neuroMoth/3-Port-4-Bottle-Rig/Documentation and Reference Material/wiring_diagram.jpg

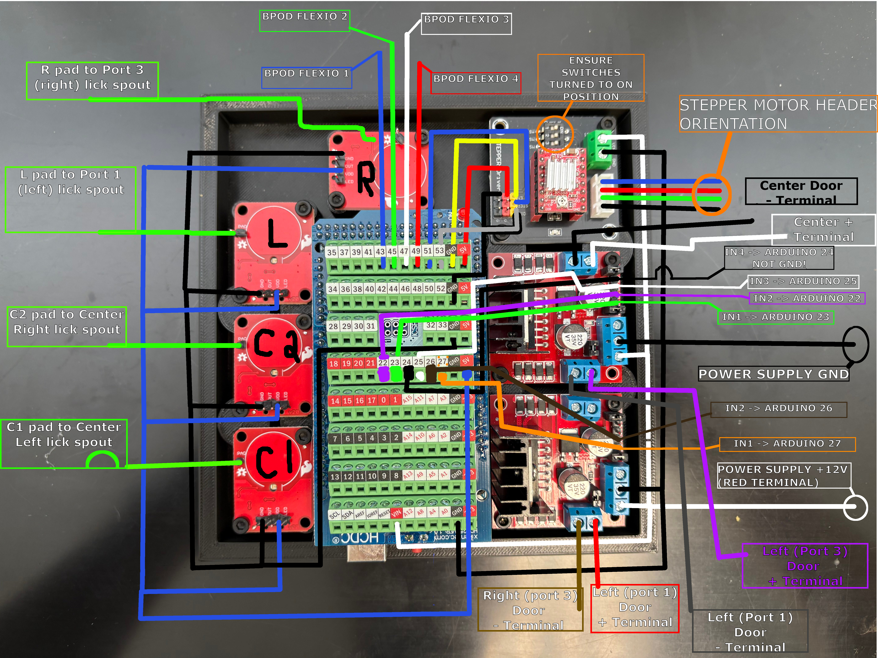
Documentation and Reference Material/wiring_diagram.jpg
