neuroMoth/3-Port-4-Bottle-Rig/Rig-Assembly-Files/Printable STLs/Other Components/Vac & Air tubing clamps-adapters-splitters/README.md

## Vacuum Pressure Adapters & Splitters

This directory contains the vacuum splitter objects I made for use in the pressure and
vac systems on the 3-port rig. Import these stl files into prusa slicer and edit 
the settings to your liking (usually 100% infill for air tight prints) and upload to 
Prusa USB to print.
