neuroMoth/3-Port-4-Bottle-Rig/Rig-Assembly-Files/Solidworks-Fusion CAD Files/Animal Box Assembly/v1/Cage (Box)/Alignment Components/README.md

## Alignment Components

These components are those that keep the cage 'locked down' into place on the 
ThorLabs breadboard. 

There are two variants: 

- Large -> Used on cage sides and rear. 

- Small -> Used on the front nearest to the delivery system.
