neuroMoth/3-Port-4-Bottle-Rig/Rig-Assembly-Files/Printable STLs/Stimulus Delivery Frame/Spout Mounts/Print Spout Mount Assembly v2.1.3mf

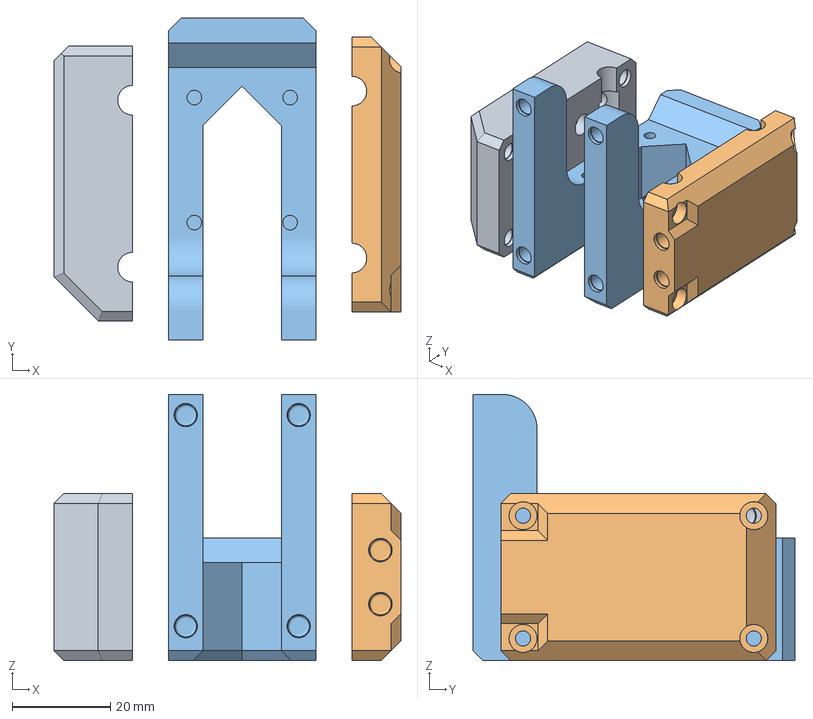
[picture p2: CAD file, 2026-10-29]
Rig-Assembly-Files/Printable STLs/Stimulus Delivery Frame/Spout Mounts/Print Spout Mount Assembly v2.1.3mf
70.7 x 65.5 x 54.2 mm
Spout Mount Assembly v2.1.stl_1
Spout Mount Assembly v2.1.stl_3
Spout Mount Assembly v2.1.stl_2
