neuroMoth/3-Port-4-Bottle-Rig/Rig-Assembly-Files/Printable STLs/Other Components/Spout Drain Assembly/Spout Drain Assembly - ALL required Parts for ONE.3mf

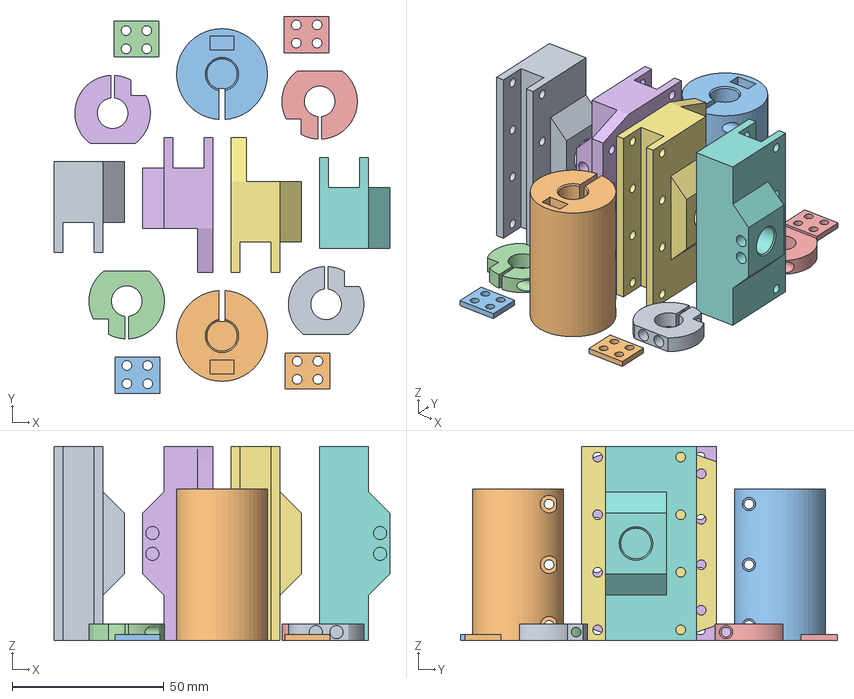
[picture p3: CAD file, 2025-09-26]
Rig-Assembly-Files/Printable STLs/Other Components/Spout Drain Assembly/Spout Drain Assembly - ALL required Parts for ONE.3mf
110.8 x 124.4 x 64.0 mm
Spout Drain Assembly - 10x100mm Linear Rod Clamp-5.STL
Spout Drain Assembly - Clamp to Base Bracket-1.STL
Spout Drain Assembly - Clamp to Base Bracket-2.STL
Spout Drain Assembly - Clamp to Base Bracket-3.STL
Spout Drain Assembly - Clamp to Base Bracket-4.STL
Spout Drain Assembly - Mount Bottom Mirror-1.STL
Spout Drain Assembly - Mount Bottom-1.STL
Spout Drain Assembly - Mount Mirrored-1.STL
Spout Drain Assembly - Mount-1.STL
Spout Drain Assembly - rod connector-1.STL
Spout Drain Assembly - rod connector-2.STL
Spout Drain Assembly - 10x100mm Linear Rod Clamp-2.STL
Spout Drain Assembly - 10x100mm Linear Rod Clamp-3.STL
Spout Drain Assembly - 10x100mm Linear Rod Clamp-4.STL
