neuroMoth/3-Port-4-Bottle-Rig/Rig-Assembly-Files/Printable STLs/Other Components/Spout Drain Assembly/Spout Drain Assembly - Mount-1.STL

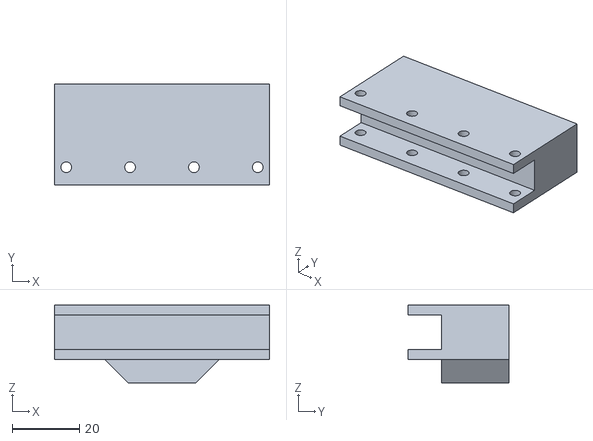
[picture p4: CAD file, 2025-09-20]
Rig-Assembly-Files/Printable STLs/Other Components/Spout Drain Assembly/Spout Drain Assembly - Mount-1.STL
64.0 x 30.0 x 23.2
