neuroMoth/3-Port-4-Bottle-Rig/Rig-Assembly-Files/Printable STLs/Other Components/Spout Drain Assembly/Spout Drain Assembly - Mid-Height Attachment Arms-1.STL

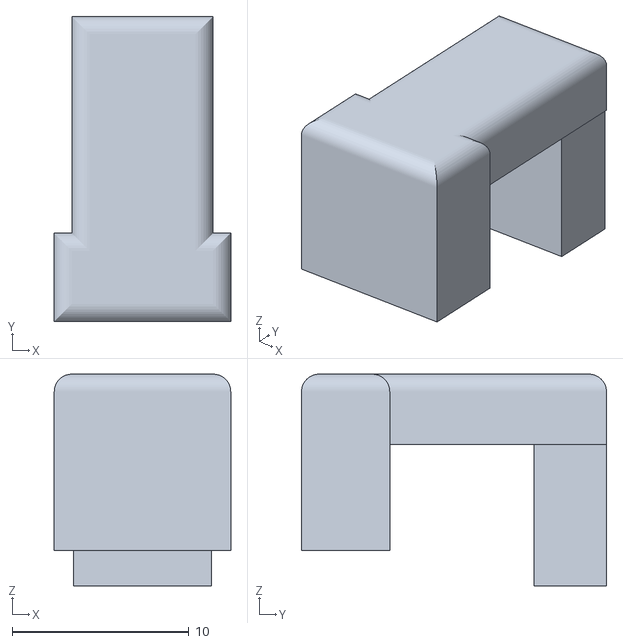
[picture p5: CAD file, 2025-09-20]
Rig-Assembly-Files/Printable STLs/Other Components/Spout Drain Assembly/Spout Drain Assembly - Mid-Height Attachment Arms-1.STL
10.0 x 17.3 x 12.0
