neuroMoth/3-Port-4-Bottle-Rig/Rig-Assembly-Files/Printable STLs/Other Components/Spout Drain Assembly/Spout Drain Assembly - Base Connecting Rail-1.STL

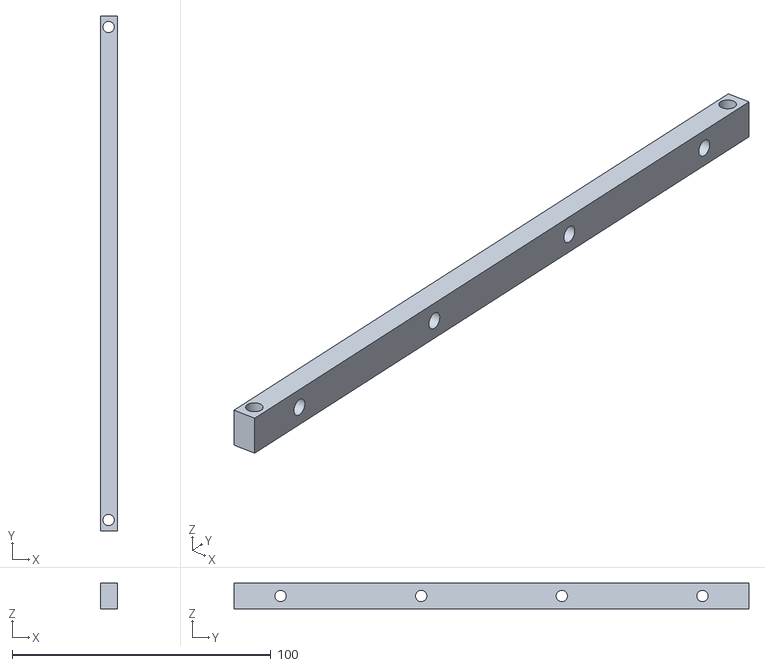
[picture p6: CAD file, 2025-09-20]
Rig-Assembly-Files/Printable STLs/Other Components/Spout Drain Assembly/Spout Drain Assembly - Base Connecting Rail-1.STL
6.50 x 199.0 x 10.0
