neuroMoth/3-Port-4-Bottle-Rig/Rig-Assembly-Files/Printable STLs/Other Components/Spout Drain Assembly/Spout Drain Assembly - Base Cover-1.STL

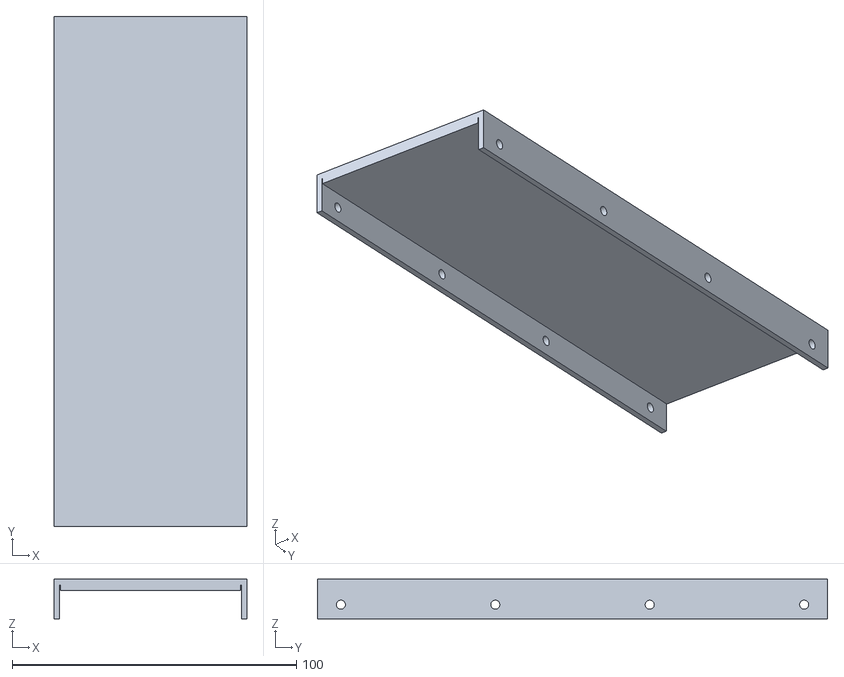
[picture p7: CAD file, 2025-09-20]
Rig-Assembly-Files/Printable STLs/Other Components/Spout Drain Assembly/Spout Drain Assembly - Base Cover-1.STL
67.9 x 179.6 x 14.0
