neuroMoth/3-Port-4-Bottle-Rig/Rig-Assembly-Files/Printable STLs/Other Components/Spout Drain Assembly/Spout Drain Assembly - Mount Bottom-1.STL

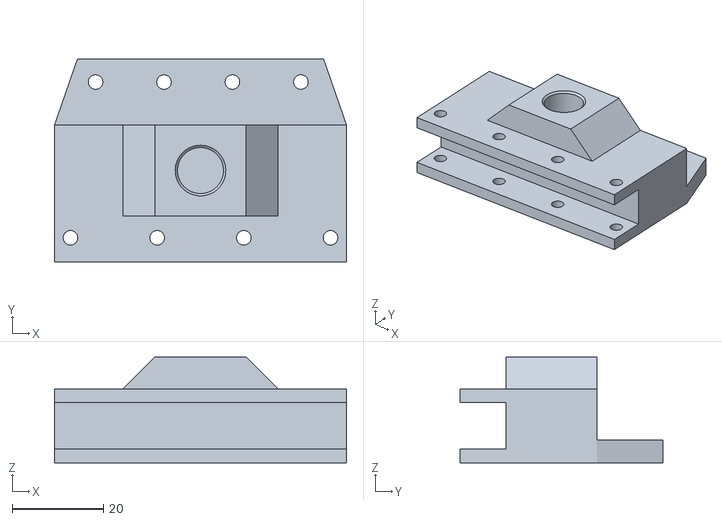
[picture p8: CAD file, 2025-09-20]
Rig-Assembly-Files/Printable STLs/Other Components/Spout Drain Assembly/Spout Drain Assembly - Mount Bottom-1.STL
64.0 x 44.4 x 23.2
