neuroMoth/3-Port-4-Bottle-Rig/Rig-Assembly-Files/Printable STLs/Other Components/Spout Drain Assembly/Spout Drain Assembly - 10x100mm Linear Rod Clamp-5.STL

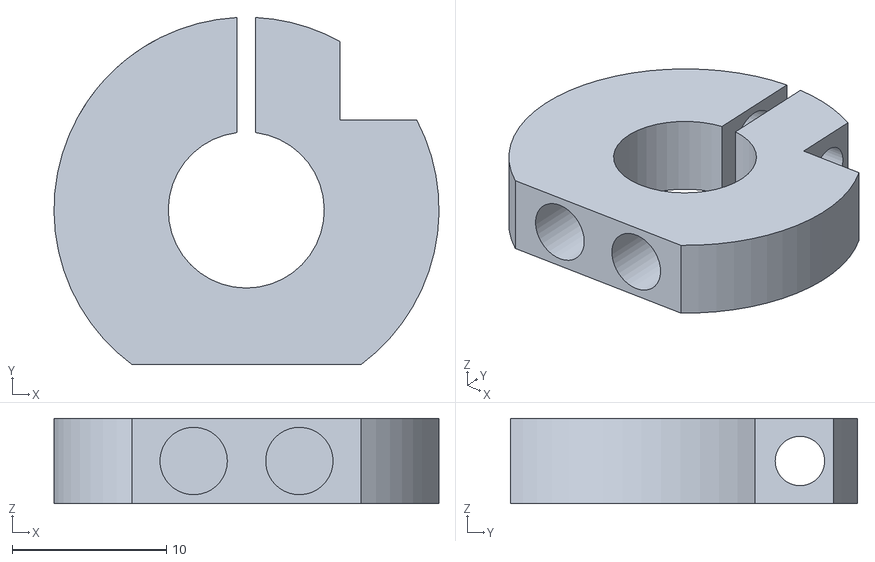
[picture p11: CAD file, 2025-09-20]
Rig-Assembly-Files/Printable STLs/Other Components/Spout Drain Assembly/Spout Drain Assembly - 10x100mm Linear Rod Clamp-5.STL
24.9 x 22.5 x 5.53
