neuroMoth/3-Port-4-Bottle-Rig/Rig-Assembly-Files/Printable STLs/Valve and Stimulus Loading Frame/Syringe and Valve Holder v3/Valve Holder v3.2 (Main).stl

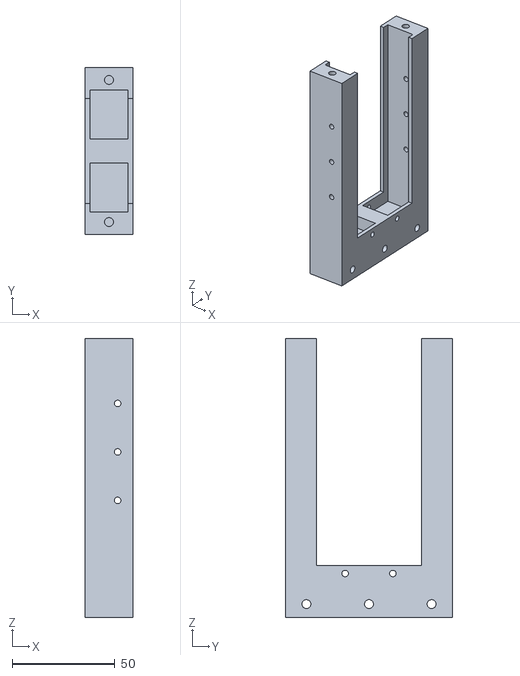
[picture p12: CAD file, 2026-02-14]
Rig-Assembly-Files/Printable STLs/Valve and Stimulus Loading Frame/Syringe and Valve Holder v3/Valve Holder v3.2 (Main).stl
23.4 x 81.3 x 135.9
