neuroMoth/3-Port-4-Bottle-Rig/Rig-Assembly-Files/Printable STLs/Other Components/Spout Drain Assembly/Spout Drain Assembly - Copy of Spout Drain Plate-1.STL

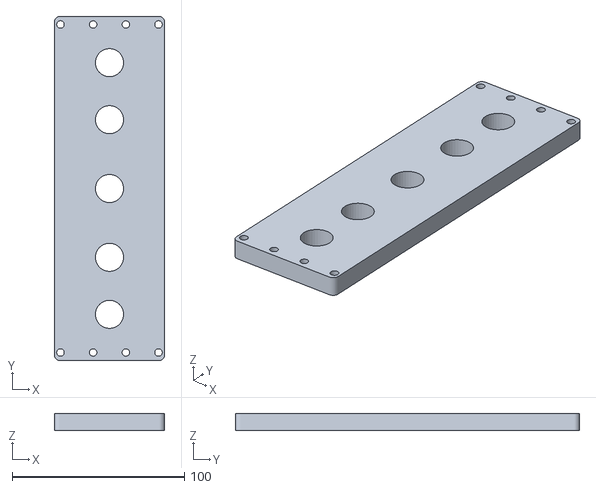
[picture p14: CAD file, 2025-09-20]
Rig-Assembly-Files/Printable STLs/Other Components/Spout Drain Assembly/Spout Drain Assembly - Copy of Spout Drain Plate-1.STL
64.0 x 200.0 x 10.1
