neuroMoth/3-Port-4-Bottle-Rig/Rig-Assembly-Files/Printable STLs/Valve and Stimulus Loading Frame/Syringe and Valve Holder v3/Full Electronics Shield.stl

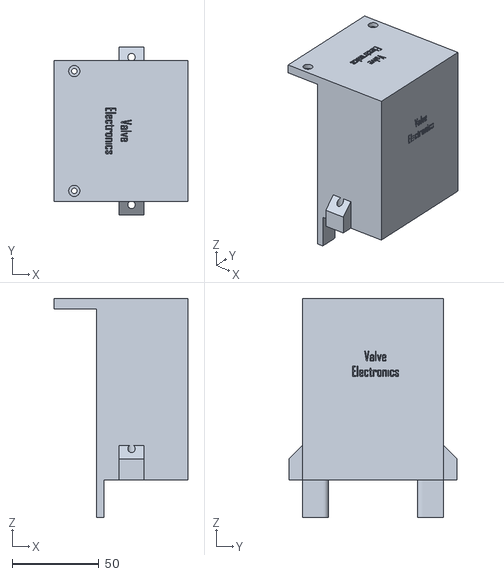
[picture p15: CAD file, 2026-02-14]
Rig-Assembly-Files/Printable STLs/Valve and Stimulus Loading Frame/Syringe and Valve Holder v3/Full Electronics Shield.stl
77.4 x 97.3 x 126.6
