neuroMoth/3-Port-4-Bottle-Rig/Rig-Assembly-Files/Printable STLs/Animal Box Assembly/Alignment Components/ALL Cage Alignment Components.3mf

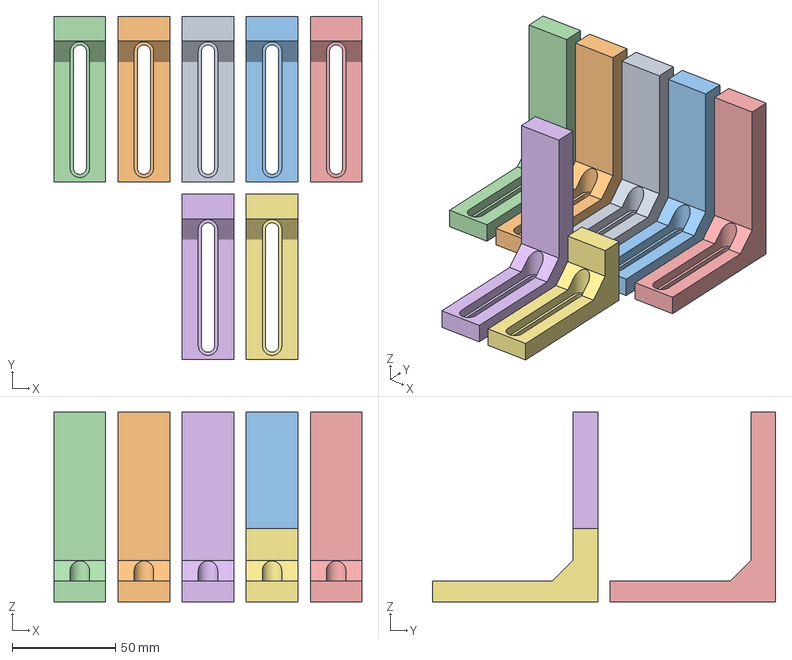
[picture p16: CAD file, 2026-10-28]
Rig-Assembly-Files/Printable STLs/Animal Box Assembly/Alignment Components/ALL Cage Alignment Components.3mf
149.0 x 166.0 x 91.7 mm
Cage Alignment Large.STL
Cage Alignment small.STL
