neuroMoth/3-Port-4-Bottle-Rig/Rig-Assembly-Files/Printable STLs/Animal Box Assembly/Cage (Box) v2/Pee Tray/pee tray corners.3mf

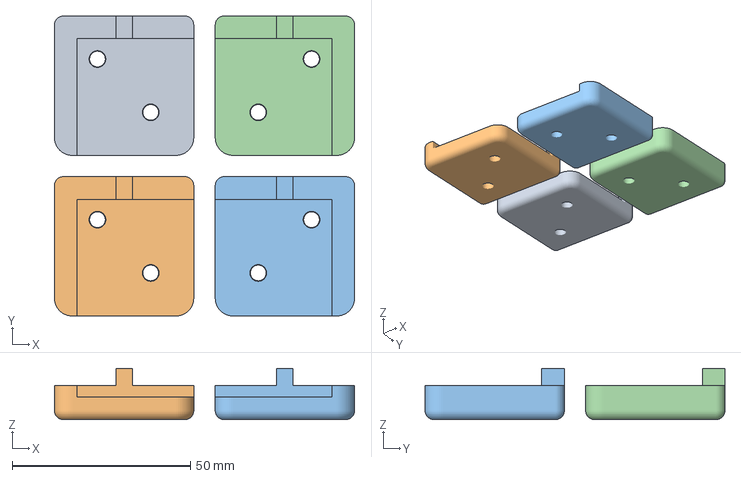
[picture p18: CAD file, 2026-10-28]
Rig-Assembly-Files/Printable STLs/Animal Box Assembly/Cage (Box) v2/Pee Tray/pee tray corners.3mf
84.2 x 84.1 x 14.4 mm
pee tray corner 2.stl
pee tray corner 1.stl
