neuroMoth/3-Port-4-Bottle-Rig/Rig-Assembly-Files/Printable STLs/Animal Box Assembly/Cage (Box) v2/Top/Lock Keepers Type A/Top Lock Keepers v2.3.3mf

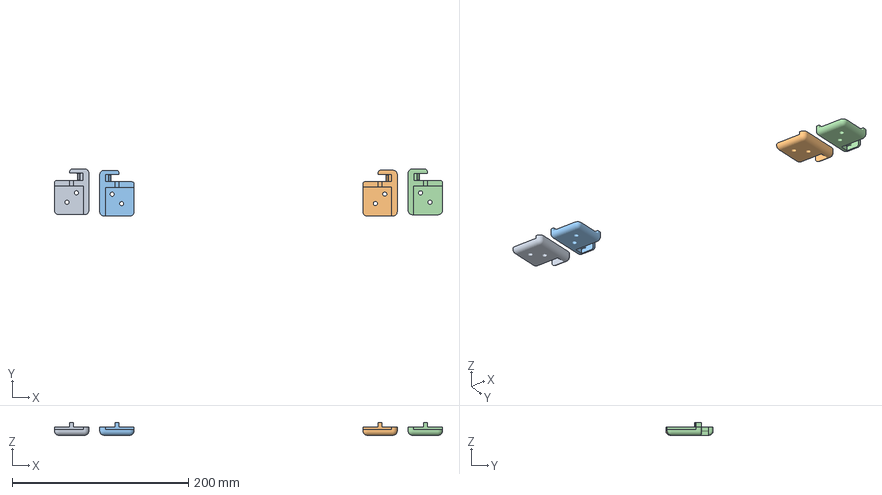
[picture p19: CAD file, 2026-05-29]
Rig-Assembly-Files/Printable STLs/Animal Box Assembly/Cage (Box) v2/Top/Lock Keepers Type A/Top Lock Keepers v2.3.3mf
440.3 x 53.7 x 14.4 mm
Top Lock Keepers - TVD Edit3.stl_1
Top Lock Keepers - TVD Edit3.stl_1_2
