neuroMoth/3-Port-4-Bottle-Rig/Rig-Assembly-Files/Printable STLs/Animal Box Assembly/Cage (Box) v2/Top/Top Handle v2.3mf

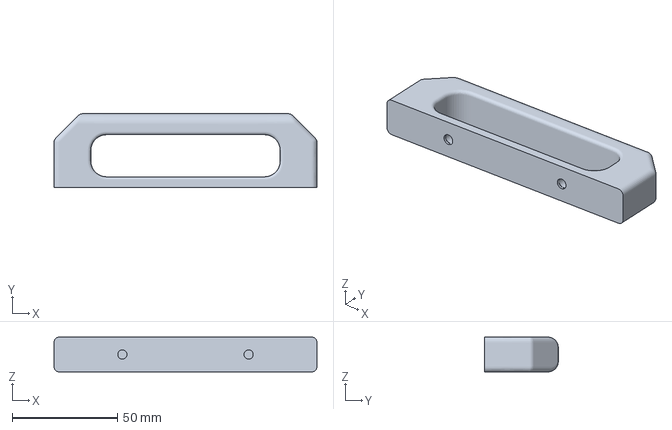
[picture p20: CAD file, 2026-10-29]
Rig-Assembly-Files/Printable STLs/Animal Box Assembly/Cage (Box) v2/Top/Top Handle v2.3mf
125.0 x 35.0 x 16.6 mm
