neuroMoth/3-Port-4-Bottle-Rig/Rig-Assembly-Files/Printable STLs/Other Components/electronics cases-covers/Barrier-Strip-Covers/Barrier Strip Case - Both components for ONE.3mf

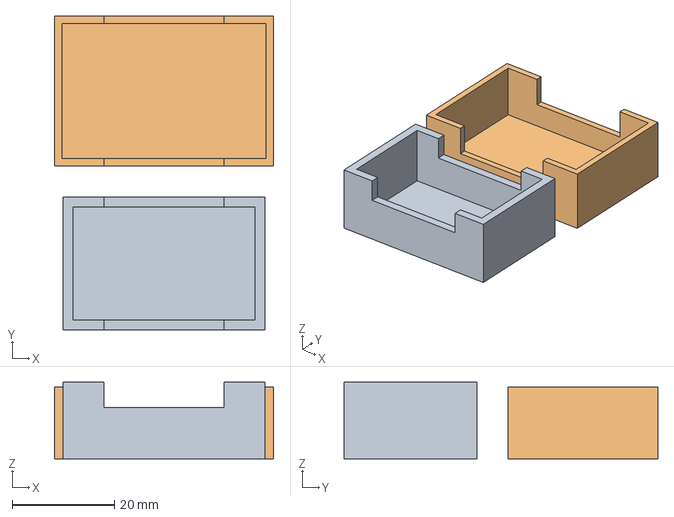
[picture p21: CAD file, 2025-09-20]
Rig-Assembly-Files/Printable STLs/Other Components/electronics cases-covers/Barrier-Strip-Covers/Barrier Strip Case - Both components for ONE.3mf
42.8 x 61.3 x 15.0 mm
Barrier Strip Case.STL
Barrier Strip Cover.STL
