neuroMoth/3-Port-4-Bottle-Rig/Rig-Assembly-Files/Printable STLs/Other Components/electronics cases-covers/extra-valve-driver-case/All Valve Driver Case Components.3mf

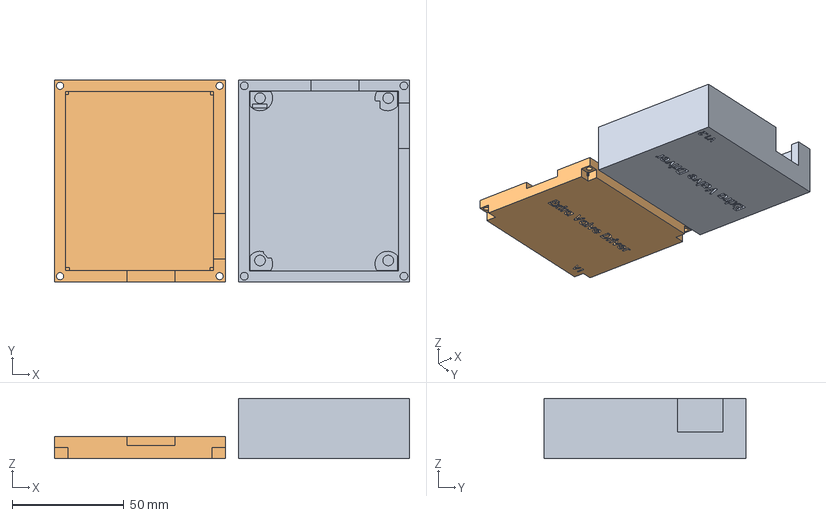
[picture p22: CAD file, 2025-09-26]
Rig-Assembly-Files/Printable STLs/Other Components/electronics cases-covers/extra-valve-driver-case/All Valve Driver Case Components.3mf
158.5 x 90.0 x 27.0 mm
Valve Driver Case.STL
Valve Driver Cover.STL
