neuroMoth/3-Port-4-Bottle-Rig/Rig-Assembly-Files/Printable STLs/Other Components/electronics cases-covers/main-electronics-box/case cover.STL

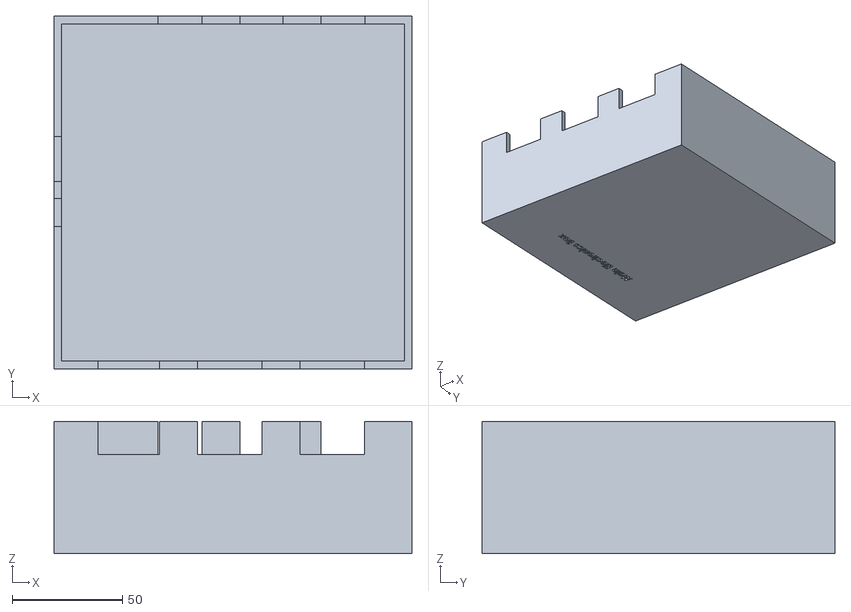
[picture p23: CAD file, 2025-09-09]
Rig-Assembly-Files/Printable STLs/Other Components/electronics cases-covers/main-electronics-box/case cover.STL
162.5 x 160.1 x 60.0
