neuroMoth/3-Port-4-Bottle-Rig/Rig-Assembly-Files/Printable STLs/Other Components/electronics cases-covers/Signal Enhancer Case/Signal Enhancer Cover.STL

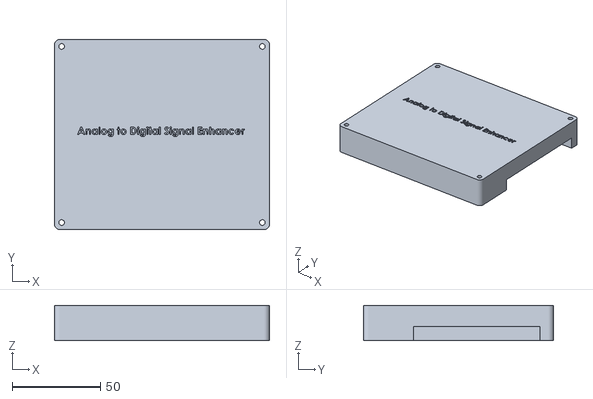
[picture p24: CAD file, 2025-09-20]
Rig-Assembly-Files/Printable STLs/Other Components/electronics cases-covers/Signal Enhancer Case/Signal Enhancer Cover.STL
121.5 x 107.5 x 20.0
