neuroMoth/3-Port-4-Bottle-Rig/Rig-Assembly-Files/Printable STLs/Other Components/Vac & Air tubing clamps-adapters-splitters/Nitrogen Manifold Holder.3mf

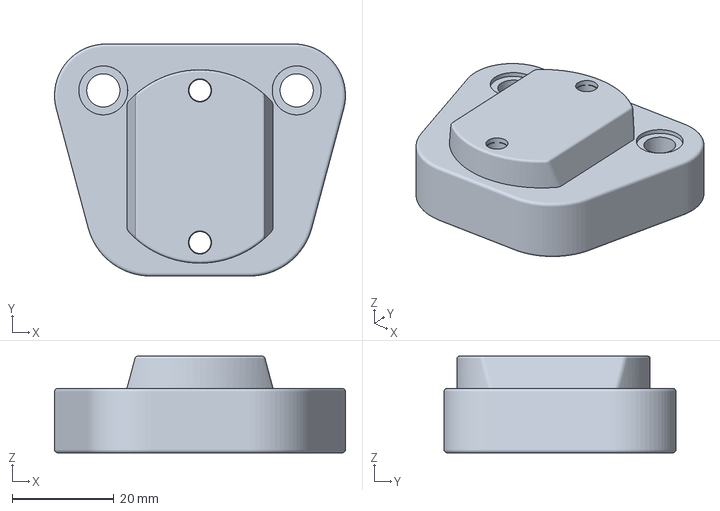
[picture p25: CAD file, 2026-10-29]
Rig-Assembly-Files/Printable STLs/Other Components/Vac & Air tubing clamps-adapters-splitters/Nitrogen Manifold Holder.3mf
57.3 x 45.7 x 19.0 mm
