neuroMoth/3-Port-4-Bottle-Rig/Rig-Assembly-Files/Printable STLs/Stimulus Delivery Frame/Delivery Frame Body/frame tower top right bracket v2.stl

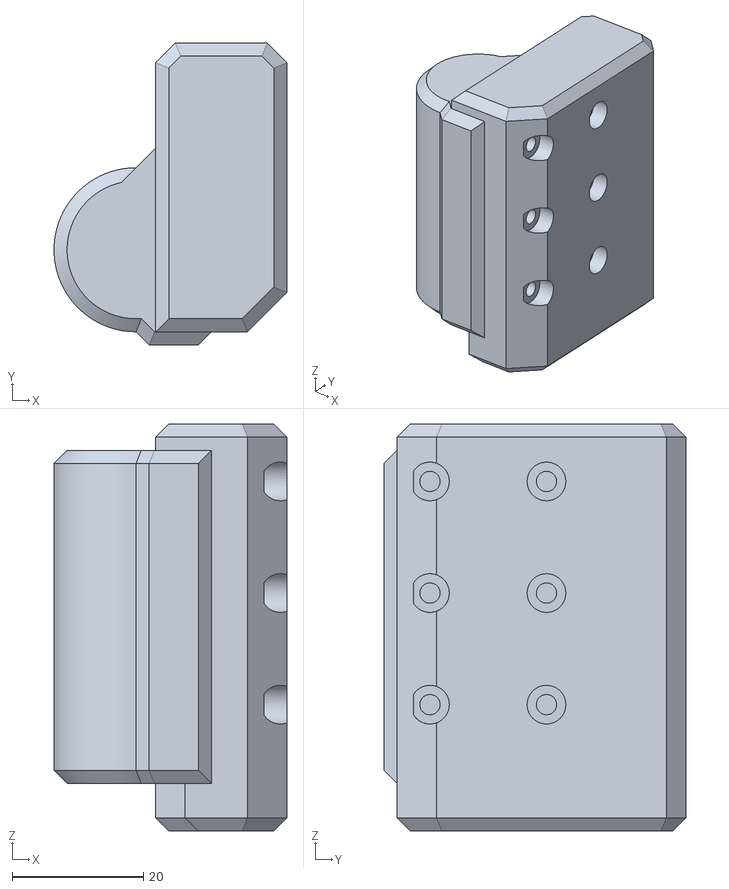
[picture p26: CAD file, 2026-10-29]
Rig-Assembly-Files/Printable STLs/Stimulus Delivery Frame/Delivery Frame Body/frame tower top right bracket v2.stl
35.5 x 46.0 x 62.0
