neuroMoth/3-Port-4-Bottle-Rig/Rig-Assembly-Files/Printable STLs/Stimulus Delivery Frame/Delivery Frame Body/v2/ALL frame tower top brackets.3mf

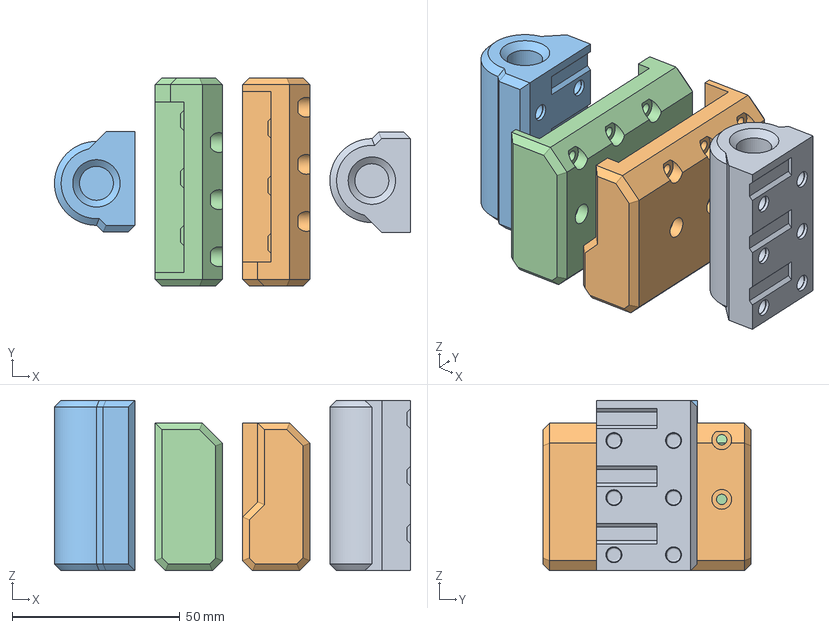
[picture p27: CAD file, 2026-09-28]
Rig-Assembly-Files/Printable STLs/Stimulus Delivery Frame/Delivery Frame Body/v2/ALL frame tower top brackets.3mf
106.0 x 62.0 x 50.8 mm
frame tower top right bracket v2.stl_1
frame tower top right bracket v2.stl_2
frame tower top left bracket v2.stl_1
frame tower top left bracket v2.stl_2
