neuroMoth/3-Port-4-Bottle-Rig/Rig-Assembly-Files/Printable STLs/Stimulus Delivery Frame/Doors/Center Door with Vac/Center Door&Vac Rail Attachment.stl

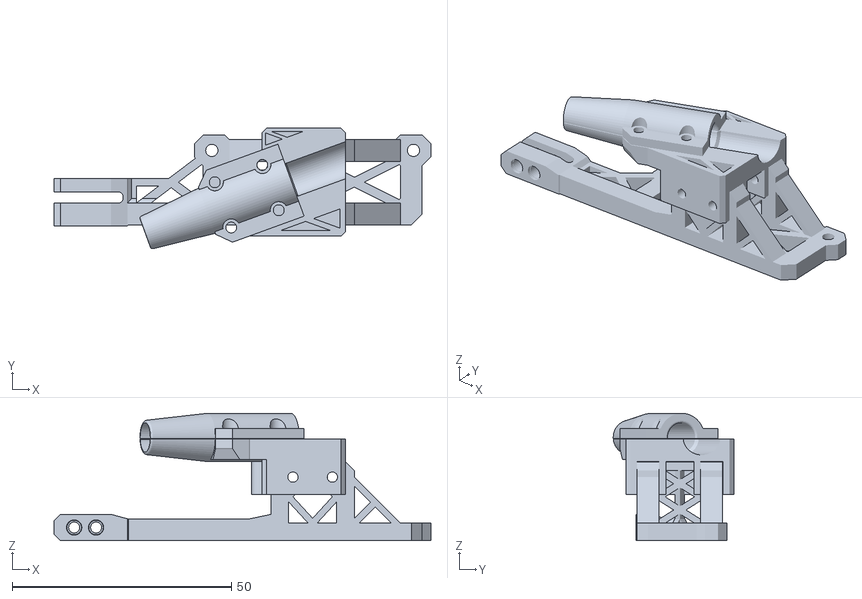
[picture p28: CAD file, 2026-07-28]
Rig-Assembly-Files/Printable STLs/Stimulus Delivery Frame/Doors/Center Door with Vac/Center Door&Vac Rail Attachment.stl
86.0 x 27.5 x 29.1
