neuroMoth/3-Port-4-Bottle-Rig/Rig-Assembly-Files/Printable STLs/Stimulus Delivery Frame/Doors/Lateral Door/Lateral Door Top Bracket v2.3mf

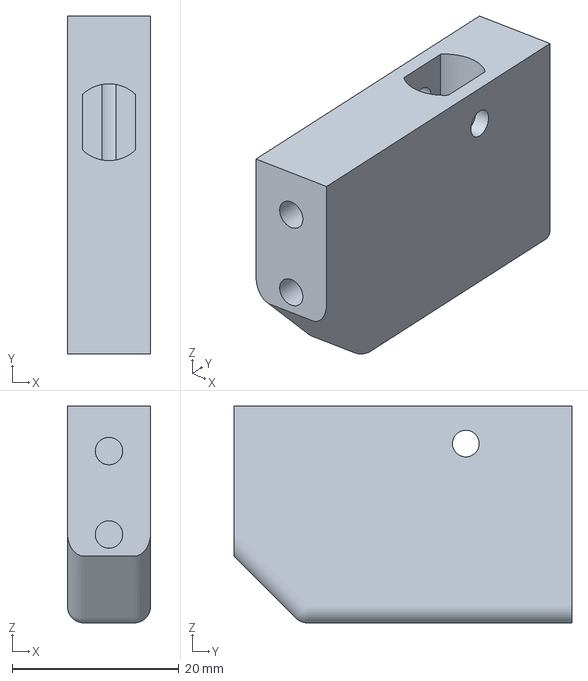
[picture p29: CAD file, 2026-07-28]
Rig-Assembly-Files/Printable STLs/Stimulus Delivery Frame/Doors/Lateral Door/Lateral Door Top Bracket v2.3mf
9.98 x 40.5 x 26.0 mm
