neuroMoth/3-Port-4-Bottle-Rig/Rig-Assembly-Files/Printable STLs/Stimulus Delivery Frame/Doors/v2/Center Door&Vac Rail Attachment.3mf

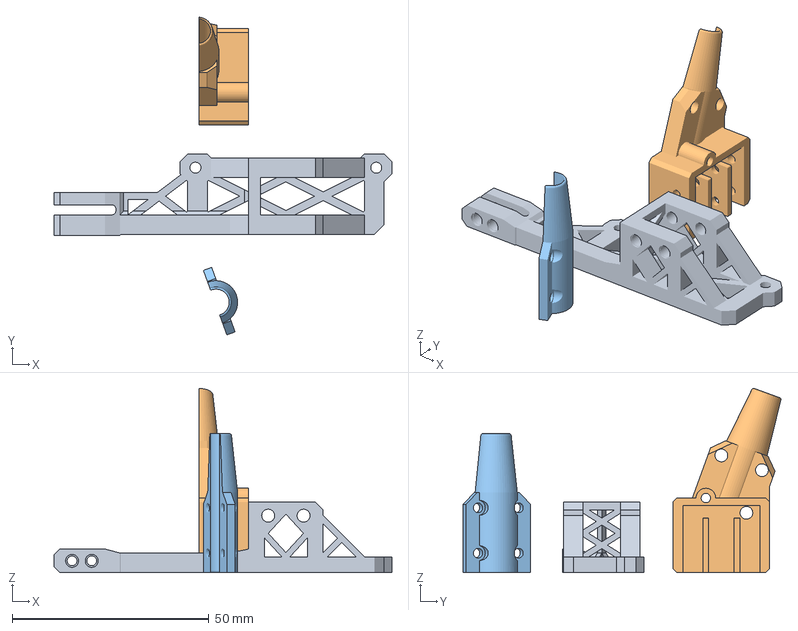
[picture p30: CAD file, 2026-09-06]
Rig-Assembly-Files/Printable STLs/Stimulus Delivery Frame/Doors/v2/Center Door&Vac Rail Attachment.3mf
86.0 x 80.9 x 46.9 mm
Center Door&Vac Rail Attachment.stl_1
Center Door&Vac Rail Attachment.stl_2
Center Door&Vac Rail Attachment.stl_3
