neuroMoth/3-Port-4-Bottle-Rig/Rig-Assembly-Files/Printable STLs/Stimulus Delivery Frame/Spout Assembly/Teflon Tube Vac Hole Tool v3.3mf

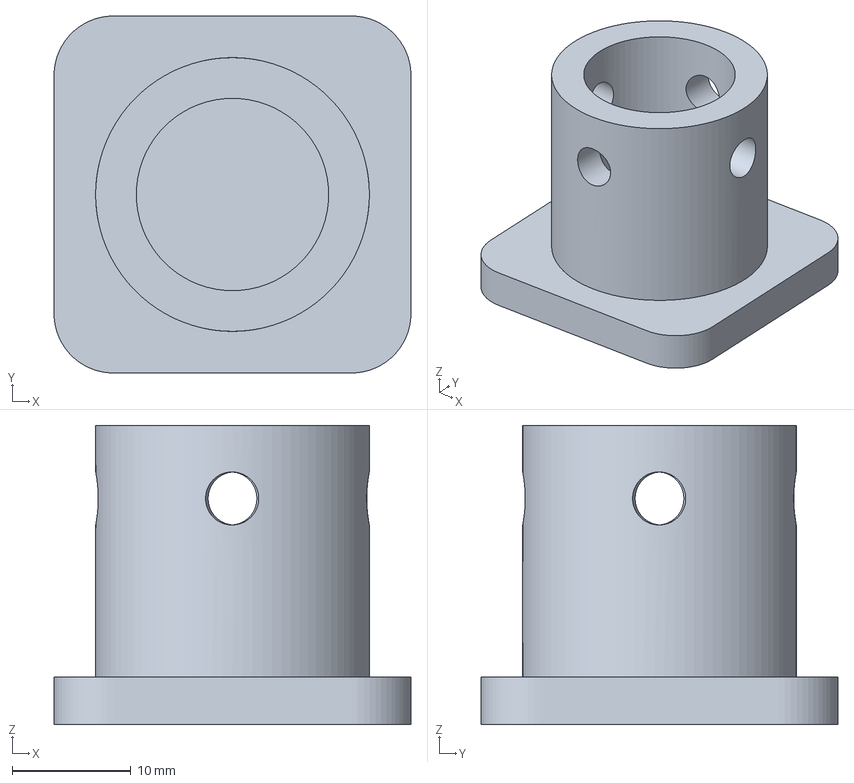
[picture p31: CAD file, 2026-10-29]
Rig-Assembly-Files/Printable STLs/Stimulus Delivery Frame/Spout Assembly/Teflon Tube Vac Hole Tool v3.3mf
30.0 x 30.0 x 25.1 mm
