neuroMoth/3-Port-4-Bottle-Rig/Rig-Assembly-Files/Printable STLs/Valve and Stimulus Loading Frame/Hybrid Chromaflex and Syringe Columns/Chromaflex Rinse Column Holder.stl

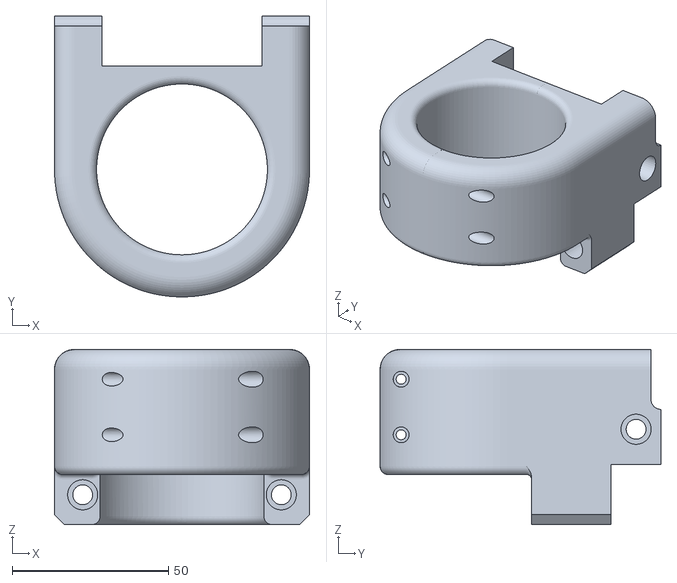
[picture p32: CAD file, 2026-10-29]
Rig-Assembly-Files/Printable STLs/Valve and Stimulus Loading Frame/Hybrid Chromaflex and Syringe Columns/Chromaflex Rinse Column Holder.stl
81.5 x 89.8 x 56.0
