neuroMoth/3-Port-4-Bottle-Rig/Rig-Assembly-Files/Printable STLs/Valve and Stimulus Loading Frame/Syringe Holder v2/Spout+Valve Tubing Clamp v6.stl

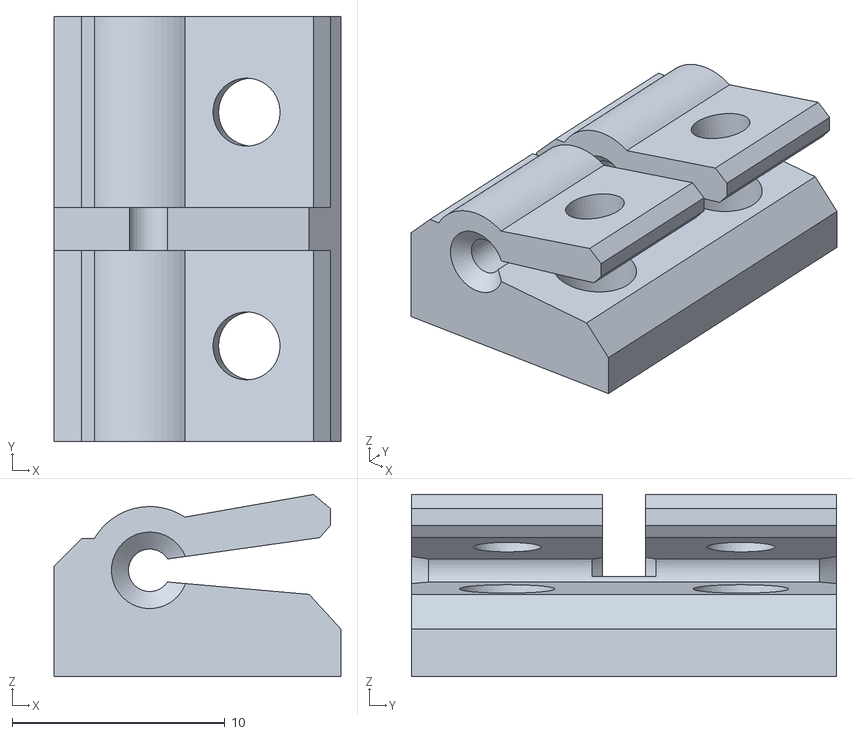
[picture p33: CAD file, 2025-12-12]
Rig-Assembly-Files/Printable STLs/Valve and Stimulus Loading Frame/Syringe Holder v2/Spout+Valve Tubing Clamp v6.stl
13.5 x 20.0 x 8.57
