neuroMoth/3-Port-4-Bottle-Rig/Rig-Assembly-Files/Printable STLs/Valve and Stimulus Loading Frame/Valve Sound Attenuation Chamber/Valve Sound Attenuation Chamber Lid Cap.3mf

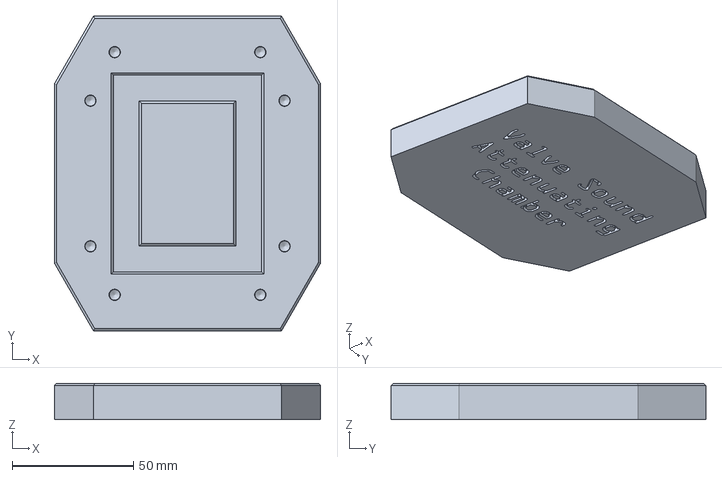
[picture p34: CAD file, 2026-10-29]
Rig-Assembly-Files/Printable STLs/Valve and Stimulus Loading Frame/Valve Sound Attenuation Chamber/Valve Sound Attenuation Chamber Lid Cap.3mf
109.8 x 129.8 x 15.0 mm
