neuroMoth/3-Port-4-Bottle-Rig/Rig-Assembly-Files/Solidworks-Fusion CAD Files/Animal Box Assembly/v1/Cage (Box)/Top Components/STEP (Fusion)/Top Lock Latching Components.STEP

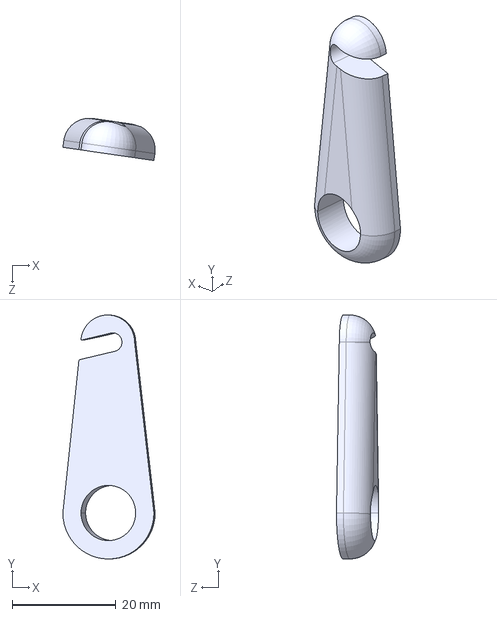
[picture p35: CAD file, 2025-12-12]
Rig-Assembly-Files/Solidworks-Fusion CAD Files/Animal Box Assembly/v1/Cage (Box)/Top Components/STEP (Fusion)/Top Lock Latching Components.STEP
17.8 x 47.1 x 8.13 mm
