neuroMoth/3-Port-4-Bottle-Rig/Rig-Assembly-Files/Solidworks-Fusion CAD Files/Stimulus Delivery Frame/v1/Frame Towers - Frame Supports - Frame Posts/SLD (Solidworks)/Frame Z Post to Breadboard Mount.SLDPRT

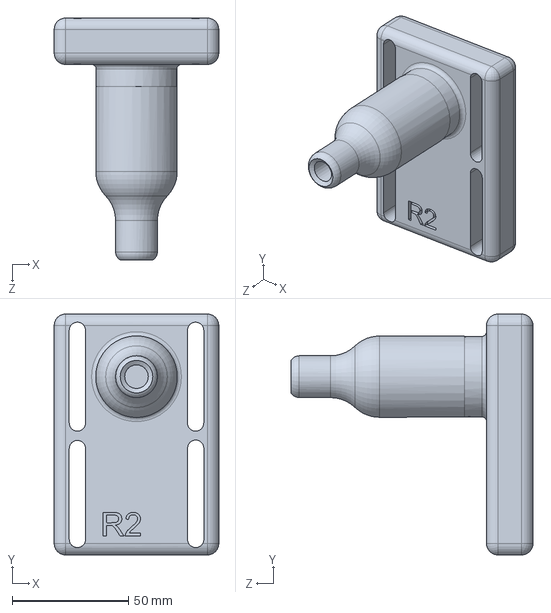
[picture p36: CAD file, 2025-09-20]
Rig-Assembly-Files/Solidworks-Fusion CAD Files/Stimulus Delivery Frame/v1/Frame Towers - Frame Supports - Frame Posts/SLD (Solidworks)/Frame Z Post to Breadboard Mount.SLDPRT
70.8 x 103.6 x 104.0 mm
