neuroMoth/3-Port-4-Bottle-Rig/Rig-Assembly-Files/Solidworks-Fusion CAD Files/Stimulus Delivery Frame/v1/Spout Door (Linear Actuator)/STEP (Fusion)/Linear Actuator Mount.STEP

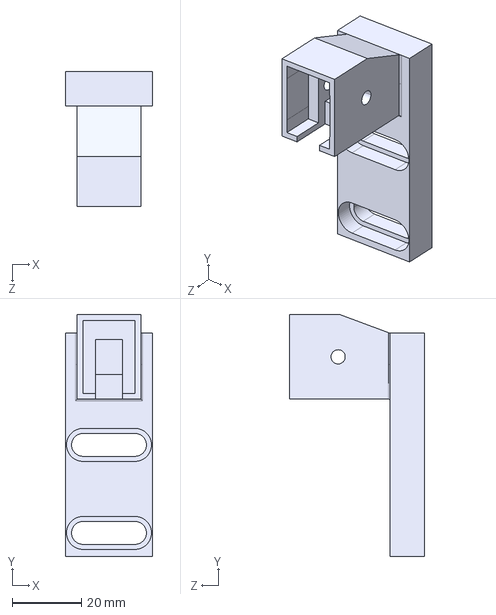
[picture p37: CAD file, 2025-09-20]
Rig-Assembly-Files/Solidworks-Fusion CAD Files/Stimulus Delivery Frame/v1/Spout Door (Linear Actuator)/STEP (Fusion)/Linear Actuator Mount.STEP
25.0 x 69.8 x 39.1 mm
