neuroMoth/3-Port-4-Bottle-Rig/Rig-Assembly-Files/Printable STLs/Animal Box Assembly/Alignment Components/Cage Alignment small.STL

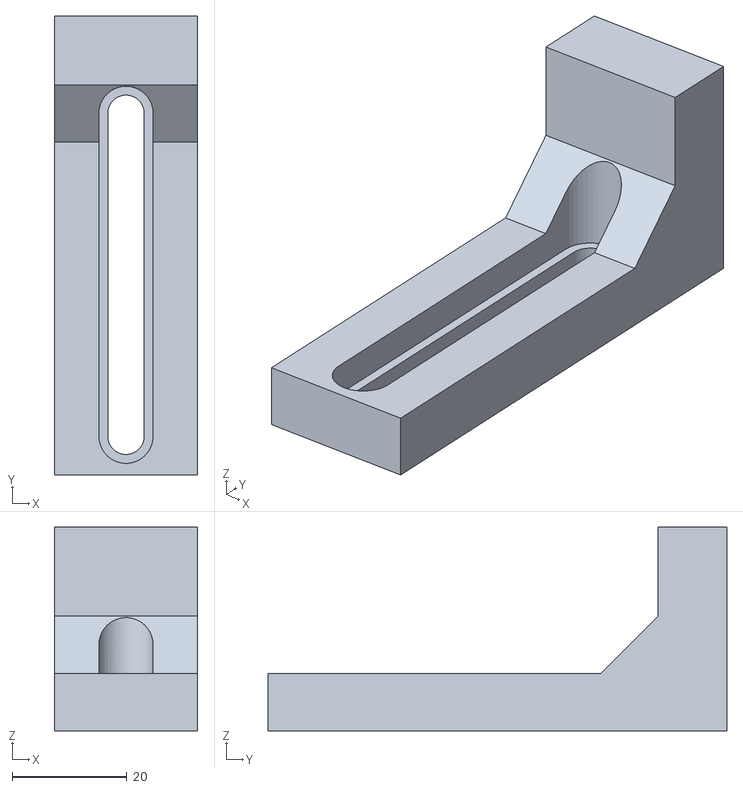
[picture p38: CAD file, 2025-08-06]
Rig-Assembly-Files/Printable STLs/Animal Box Assembly/Alignment Components/Cage Alignment small.STL
25.0 x 80.0 x 35.5
