neuroMoth/3-Port-4-Bottle-Rig/Rig-Assembly-Files/Printable STLs/Animal Box Assembly/Cage (Box) v2/Legs/Rear Legs I v2.2.3mf

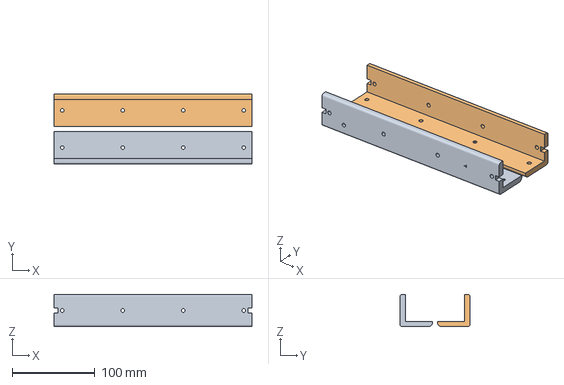
[picture p39: CAD file, 2026-10-28]
Rig-Assembly-Files/Printable STLs/Animal Box Assembly/Cage (Box) v2/Legs/Rear Legs I v2.2.3mf
239.0 x 84.2 x 39.1 mm
Rear Legs I v2.2.stl_1
Rear Legs I v2.2.stl_2
