neuroMoth/3-Port-4-Bottle-Rig/Rig-Assembly-Files/Printable STLs/Animal Box Assembly/Cage (Box) v2/Pee Tray/pee tray corner 2.stl

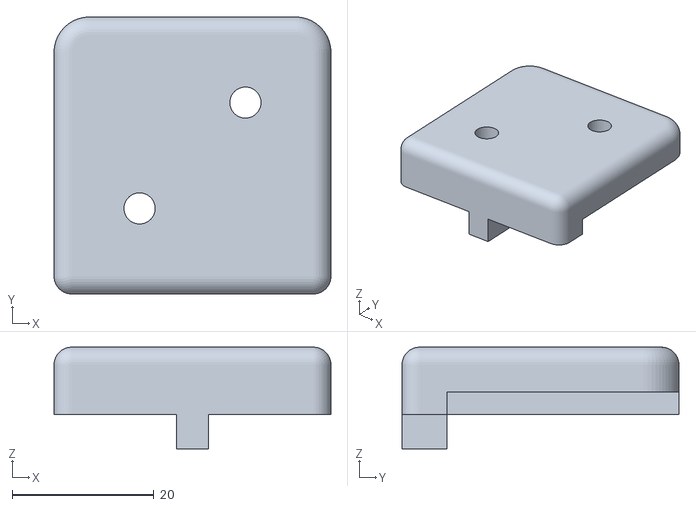
[picture p40: CAD file, 2026-10-28]
Rig-Assembly-Files/Printable STLs/Animal Box Assembly/Cage (Box) v2/Pee Tray/pee tray corner 2.stl
39.1 x 39.1 x 14.4
