neuroMoth/3-Port-4-Bottle-Rig/Rig-Assembly-Files/Printable STLs/Other Components/electronics cases-covers/Barrier-Strip-Covers/Barrier Strip Cover.STL

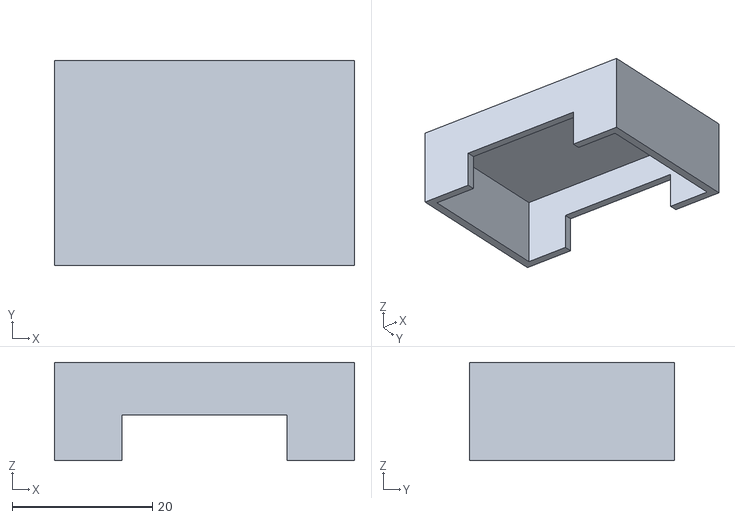
[picture p41: CAD file, 2025-09-08]
Rig-Assembly-Files/Printable STLs/Other Components/electronics cases-covers/Barrier-Strip-Covers/Barrier Strip Cover.STL
42.8 x 29.3 x 14.0
