neuroMoth/3-Port-4-Bottle-Rig/Rig-Assembly-Files/Printable STLs/Other Components/electronics cases-covers/extra-valve-driver-case/Valve Driver Cover.STL

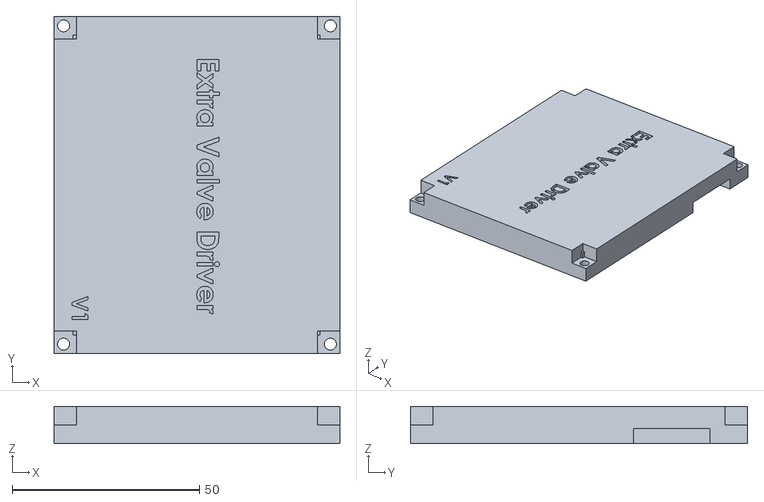
[picture p42: CAD file, 2025-09-08]
Rig-Assembly-Files/Printable STLs/Other Components/electronics cases-covers/extra-valve-driver-case/Valve Driver Cover.STL
76.2 x 90.0 x 10.0
