neuroMoth/3-Port-4-Bottle-Rig/Rig-Assembly-Files/Printable STLs/Other Components/electronics cases-covers/Signal Enhancer Case/Signal Enhancer Case.STL

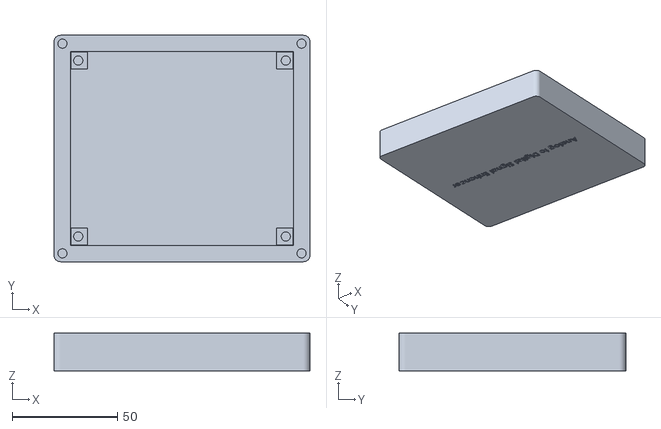
[picture p43: CAD file, 2025-09-16]
Rig-Assembly-Files/Printable STLs/Other Components/electronics cases-covers/Signal Enhancer Case/Signal Enhancer Case.STL
121.5 x 107.5 x 18.0
