neuroMoth/3-Port-4-Bottle-Rig/Rig-Assembly-Files/Printable STLs/Other Components/Vac & Air tubing clamps-adapters-splitters/Chromaflex Rinse Column Holder.3mf

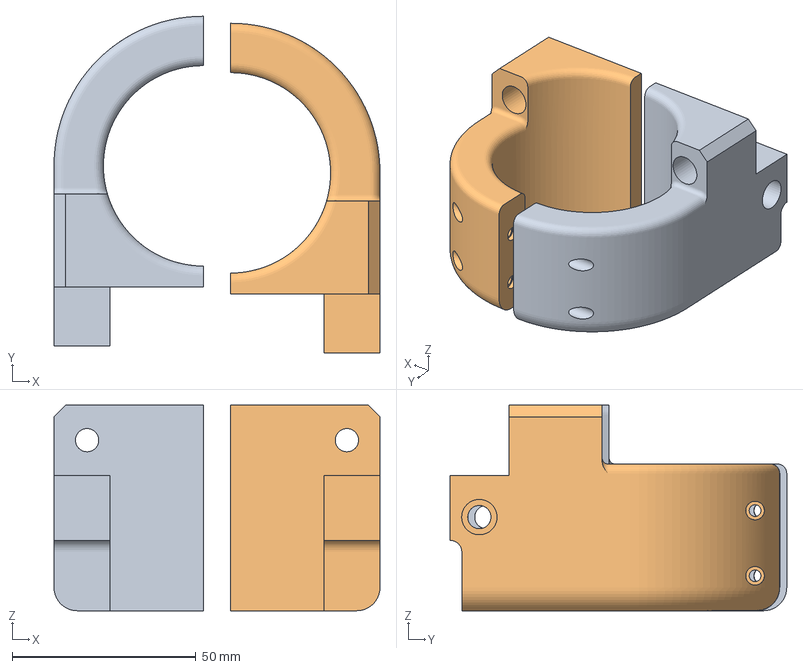
[picture p44: CAD file, 2026-10-28]
Rig-Assembly-Files/Printable STLs/Other Components/Vac & Air tubing clamps-adapters-splitters/Chromaflex Rinse Column Holder.3mf
88.8 x 91.7 x 56.0 mm
Chromaflex Column Holder.stl_1
Chromaflex Column Holder.stl_2
