neuroMoth/3-Port-4-Bottle-Rig/Rig-Assembly-Files/Printable STLs/Stimulus Delivery Frame/Doors/Lateral Door/Lateral Door Rail Attachment.stl

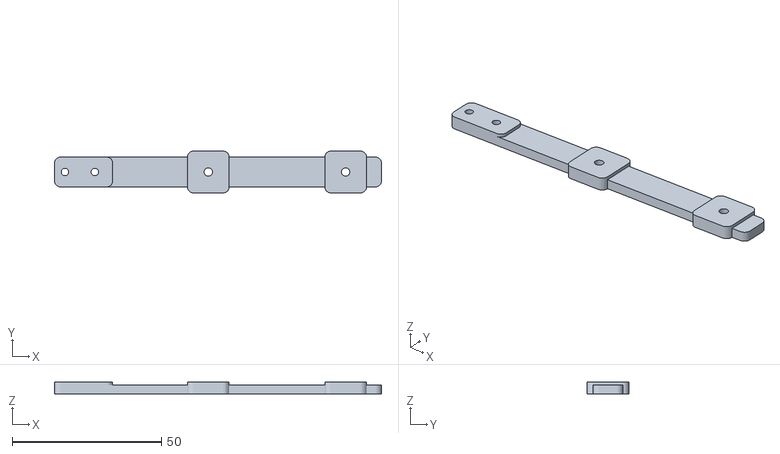
[picture p45: CAD file, 2026-07-28]
Rig-Assembly-Files/Printable STLs/Stimulus Delivery Frame/Doors/Lateral Door/Lateral Door Rail Attachment.stl
109.5 x 14.0 x 4.00
