neuroMoth/3-Port-4-Bottle-Rig/Rig-Assembly-Files/Printable STLs/Stimulus Delivery Frame/Doors/v2/Center Door Top Bracket v2.3mf

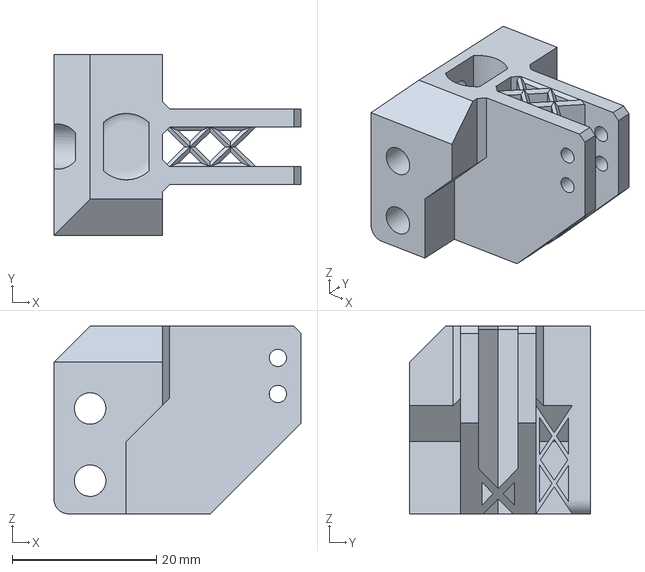
[picture p46: CAD file, 2026-07-28]
Rig-Assembly-Files/Printable STLs/Stimulus Delivery Frame/Doors/v2/Center Door Top Bracket v2.3mf
34.2 x 25.0 x 26.0 mm
