neuroMoth/3-Port-4-Bottle-Rig/Rig-Assembly-Files/Printable STLs/Stimulus Delivery Frame/Spout Assembly/Spout Spacer v3 (shorter spout).3mf

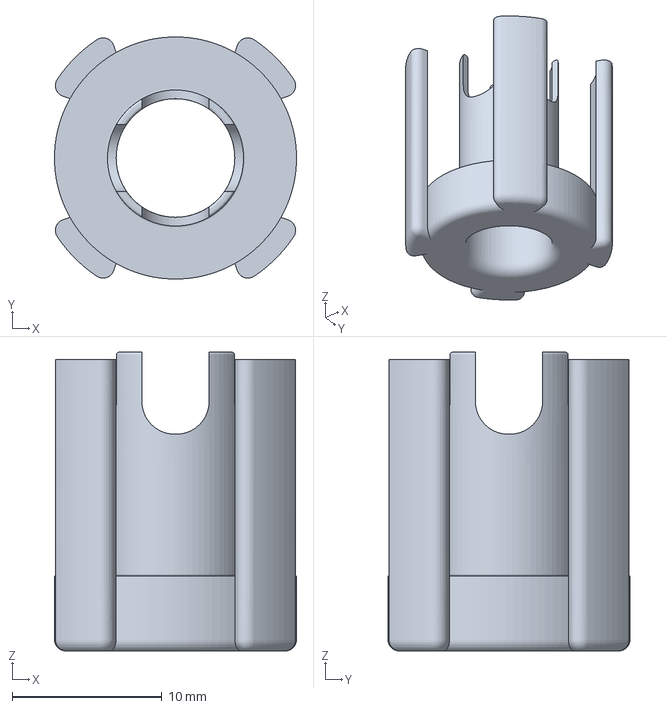
[picture p47: CAD file, 2026-10-29]
Rig-Assembly-Files/Printable STLs/Stimulus Delivery Frame/Spout Assembly/Spout Spacer v3 (shorter spout).3mf
16.2 x 16.2 x 20.0 mm
