neuroMoth/3-Port-4-Bottle-Rig/Rig-Assembly-Files/Printable STLs/Valve and Stimulus Loading Frame/Hybrid Chromaflex and Syringe Columns/Syringe Holder v5.3mf

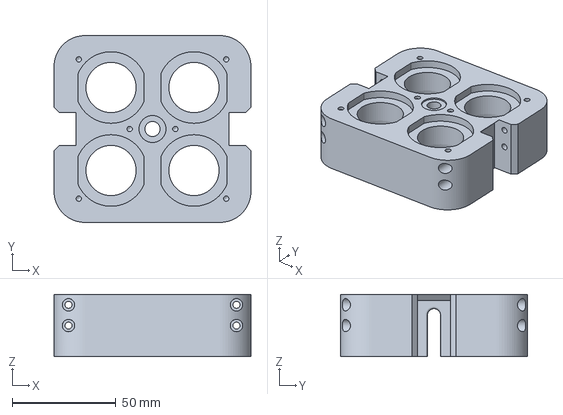
[picture p48: CAD file, 2026-10-29]
Rig-Assembly-Files/Printable STLs/Valve and Stimulus Loading Frame/Hybrid Chromaflex and Syringe Columns/Syringe Holder v5.3mf
95.0 x 90.1 x 29.9 mm
