neuroMoth/3-Port-4-Bottle-Rig/Rig-Assembly-Files/Printable STLs/Valve and Stimulus Loading Frame/Syringe and Valve Holder v3/Clamp to Base Bracket v4.3mf

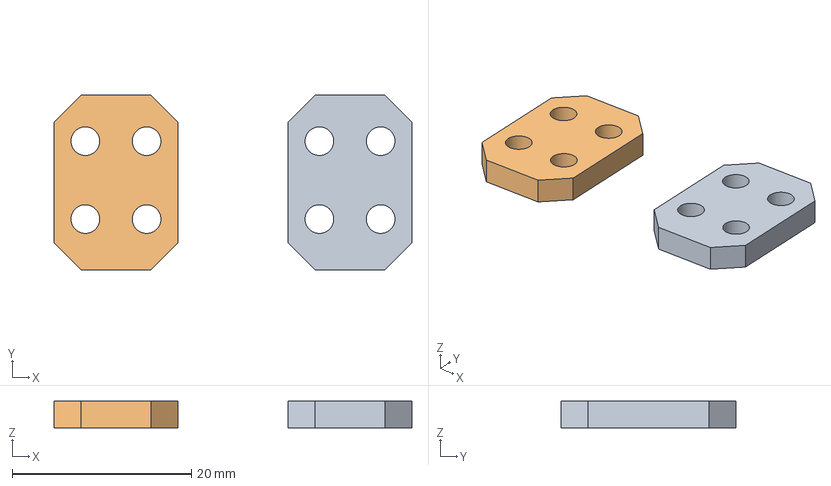
[picture p49: CAD file, 2026-06-20]
Rig-Assembly-Files/Printable STLs/Valve and Stimulus Loading Frame/Syringe and Valve Holder v3/Clamp to Base Bracket v4.3mf
40.0 x 19.5 x 3.00 mm
Clamp to Base Bracket v4.stl x 2
