neuroMoth/3-Port-4-Bottle-Rig/Rig-Assembly-Files/Printable STLs/Valve and Stimulus Loading Frame/Syringe Holder v2/All Syringe Holder Components.3mf

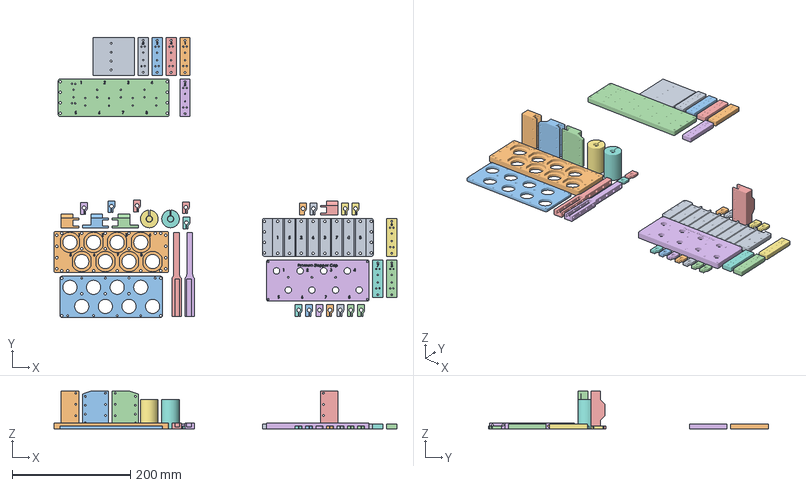
[picture p50: CAD file, 2025-09-26]
Rig-Assembly-Files/Printable STLs/Valve and Stimulus Loading Frame/Syringe Holder v2/All Syringe Holder Components.3mf
581.0 x 474.3 x 64.0 mm
Leg Mounting Plate.STL
Mount.STL
Mount Bottom.STL
Mount Bottom Mirror.STL
Mount Mirrored.STL
pressure stopper cap.STL
rod connector.STL
Stimulus Delivery System (Syringe, Valve) - Valve Mount Bottom Plate-1.STL
Stimulus Delivery System (Syringe, Valve) - Valve Mount Module 1-1.STL
Stimulus Delivery System (Syringe, Valve) - Valve Mount Module 2-1.STL
Stimulus Delivery System (Syringe, Valve) - Valve Mount Module 3-1.STL
Stimulus Delivery System (Syringe, Valve) - Valve Mount Module 4-1.STL
Stimulus Delivery System (Syringe, Valve) - Valve Mount Module 5-1.STL
Stimulus Delivery System (Syringe, Valve) - Valve Mount Module 6-1.STL
Stimulus Delivery System (Syringe, Valve) - Valve Mount Module 7-1.STL
Stimulus Delivery System (Syringe, Valve) - Valve Mount Module 8-1.STL
Syringe Holder.STL
Syringe lock.STL
test Teflon Insert Clamp.STL
Valve Mount.STL
Valve Plate to Syringe.STL
Valve Plate to Syringe mirror.STL
