neuroMoth/3-Port-4-Bottle-Rig/Rig-Assembly-Files/Printable STLs/Valve and Stimulus Loading Frame/Valve Sound Attenuation Chamber/Valve Sound Attenuation Chamber Lid Sides.3mf

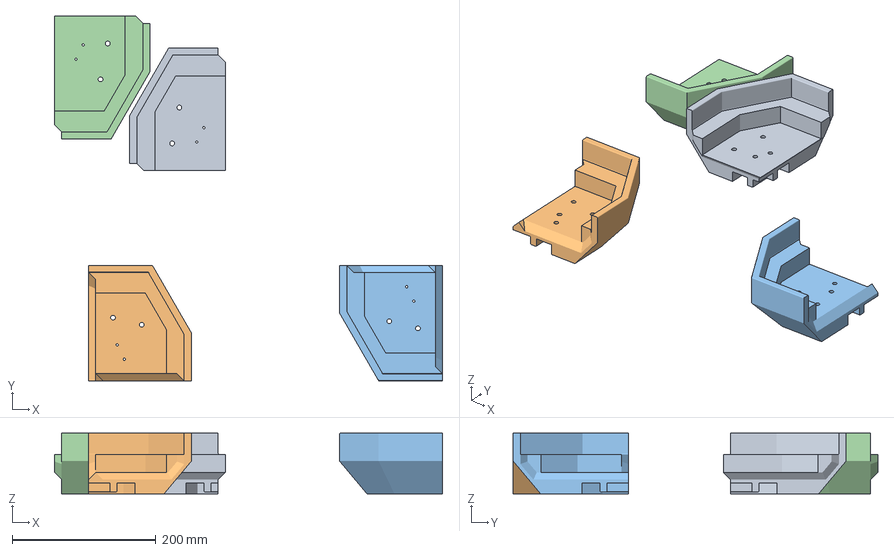
[picture p51: CAD file, 2026-10-29]
Rig-Assembly-Files/Printable STLs/Valve and Stimulus Loading Frame/Valve Sound Attenuation Chamber/Valve Sound Attenuation Chamber Lid Sides.3mf
540.7 x 508.0 x 85.0 mm
Valve Sound Attenuation Chamber - Lid Sides.stl_1
Valve Sound Attenuation Chamber - Lid Sides.stl_2
Valve Sound Attenuation Chamber - Lid Sides.stl_3
Valve Sound Attenuation Chamber - Lid Sides.stl_4
