neuroMoth/3-Port-4-Bottle-Rig/Rig-Assembly-Files/Solidworks-Fusion CAD Files/Animal Box Assembly/v1/Cage (Box)/Support Legs/SLD (Solidworks)/Front Leg - Right.SLDPRT

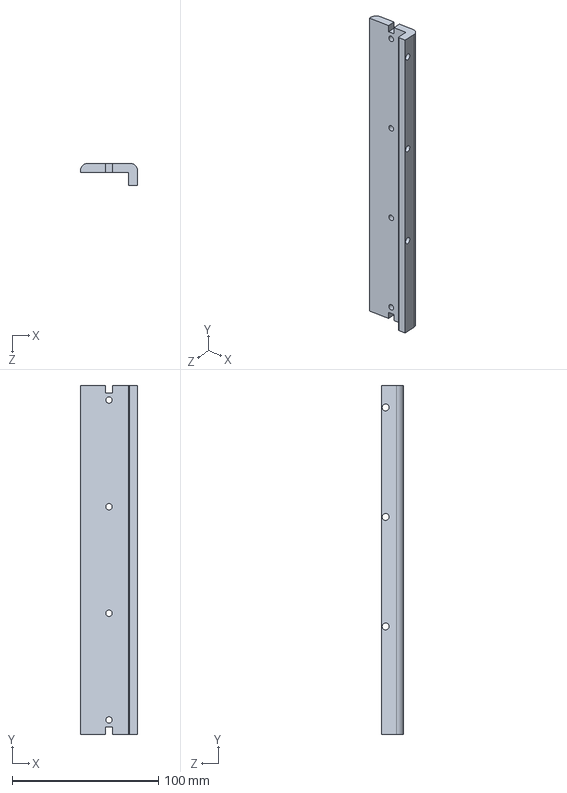
[picture p52: CAD file, 2025-09-18]
Rig-Assembly-Files/Solidworks-Fusion CAD Files/Animal Box Assembly/v1/Cage (Box)/Support Legs/SLD (Solidworks)/Front Leg - Right.SLDPRT
39.1 x 239.0 x 15.4 mm
