neuroMoth/3-Port-4-Bottle-Rig/(list of files, cad)

Other CAD files:
Rig-Assembly-Files/Solidworks-Fusion CAD Files/Stimulus Delivery Frame/v1/Spout to Delivery Frame Mounts/Lateral Spout to Delivery Frame Mount/STEP (Fusion)/lateral spout mount assembly.STEP
Rig-Assembly-Files/Solidworks-Fusion CAD Files/Stimulus Delivery Frame/v1/Spout to Delivery Frame Mounts/Teflon Delivery Tube Components/STEP (Fusion)/Teflon Clamp Assembly.STEP
Rig-Assembly-Files/Solidworks-Fusion CAD Files/Other Components/electronics cases-covers/v1/Signal Enhancer Case/STEP (Fusion)/Signal Enhancer Case Asm.STEP
Rig-Assembly-Files/Solidworks-Fusion CAD Files/Other Components/electronics cases-covers/v1/main-electronics-box/STEP (Fusion)/electronics-box-asm.STEP
Rig-Assembly-Files/Solidworks-Fusion CAD Files/Stimulus Delivery Frame/v1/Spout to Delivery Frame Mounts/Center Spout to Delivery Frame Mount/STEP (Fusion)/center spout assembly.STEP
Rig-Assembly-Files/Printable STLs/Other Components/Spout Drain Assembly/Spout Drain Assembly - Mid-Height Attachment Arms-2.STL
Rig-Assembly-Files/Printable STLs/Other Components/Spout Drain Assembly/Spout Drain Assembly - 10x100mm Linear Rod Clamp-3.STL
Rig-Assembly-Files/Printable STLs/Other Components/Spout Drain Assembly/Spout Drain Assembly - Base Connecting Rail-2.STL
Rig-Assembly-Files/Solidworks-Fusion CAD Files/Other Components/Spout Drain Assembly/v1/STEP (Fusion)/Spout Drain Assembly.STEP
Rig-Assembly-Files/Printable STLs/Other Components/Spout Drain Assembly/Spout Drain Assembly - Clamp to Base Bracket-1.STL
Rig-Assembly-Files/Printable STLs/Other Components/Spout Drain Assembly/Spout Drain Assembly - 10x100mm Linear Rod Clamp-4.STL
Rig-Assembly-Files/Printable STLs/Other Components/Spout Drain Assembly/Spout Drain Assembly - rod connector-1.STL
Rig-Assembly-Files/Printable STLs/Other Components/Spout Drain Assembly/Spout Drain Assembly - 10x100mm Linear Rod Clamp-2.STL
Rig-Assembly-Files/Printable STLs/Other Components/Spout Drain Assembly/Spout Drain Assembly - Clamp to Base Bracket-2.STL
Rig-Assembly-Files/Printable STLs/Other Components/Spout Drain Assembly/Spout Drain Assembly - Mount Mirrored-1.STL
Rig-Assembly-Files/Printable STLs/Other Components/Spout Drain Assembly/Spout Drain Assembly - Mount Bottom Mirror-1.STL
Rig-Assembly-Files/Printable STLs/Other Components/Spout Drain Assembly/Spout Drain Assembly - Clamp to Base Bracket-4.STL
Rig-Assembly-Files/Printable STLs/Valve and Stimulus Loading Frame/Syringe and Valve Holder v3/Syringe & Valve Base Rail v2 - valve holder frame.3mf
Rig-Assembly-Files/Solidworks-Fusion CAD Files/Animal Box Assembly/v1/Non-Printable-Parts/10x100mm rod.SLDPRT
Rig-Assembly-Files/Solidworks-Fusion CAD Files/Stimulus Delivery Frame/v1/Frame Towers - Frame Supports - Frame Posts/STEP (Fusion)/Frame Z Post to Breadboard Mount.STEP
Rig-Assembly-Files/Solidworks-Fusion CAD Files/Valve and Stimulus Loading Frame/Syringe Holder v2/STEP (Fusion)/Stimulus Delivery System (Syringe, Valve).STEP
Rig-Assembly-Files/Printable STLs/Stimulus Delivery Frame/Delivery Frame Body/ALL frame tower top brackets.3mf
Rig-Assembly-Files/Printable STLs/Stimulus Delivery Frame/Delivery Frame Body/v2/frame tower top right bracket v2.stl
Rig-Assembly-Files/Solidworks-Fusion CAD Files/Other Components/electronics cases-covers/v1/Barrier-Strip-Covers/STEP (Fusion)/barrier-strip-casing-with-cover.STEP
Rig-Assembly-Files/Solidworks-Fusion CAD Files/Other Components/electronics cases-covers/v1/Signal Enhancer Case/STEP (Fusion)/signal-enhancer.step.STEP
Rig-Assembly-Files/Solidworks-Fusion CAD Files/Other Components/Spout Drain Assembly/v1/STEP (Fusion)/Mount.STEP
Rig-Assembly-Files/Printable STLs/Animal Box Assembly/Alignment Components/Cage Alignment Large.STL
Rig-Assembly-Files/Printable STLs/Animal Box Assembly/Cage (Box) v1/Legs/All Cage Legs.3mf
Rig-Assembly-Files/Printable STLs/Animal Box Assembly/Cage (Box) v1/Legs/Cage Rear Leg - left.STL
Rig-Assembly-Files/Printable STLs/Animal Box Assembly/Cage (Box) v1/Legs/Cage Rear Leg - right.STL
Rig-Assembly-Files/Printable STLs/Animal Box Assembly/Cage (Box) v1/Legs/Front Leg - Left.STL
Rig-Assembly-Files/Printable STLs/Animal Box Assembly/Cage (Box) v1/Legs/Front Leg - Right.STL
Rig-Assembly-Files/Printable STLs/Animal Box Assembly/Cage (Box) v1/Top Components/ALL Cage Top Components.3mf
Rig-Assembly-Files/Printable STLs/Animal Box Assembly/Cage (Box) v1/Top Components/Cage Top Corner Pieces.3mf
Rig-Assembly-Files/Printable STLs/Animal Box Assembly/Cage (Box) v1/Top Components/Keeper/Top Lock Keeper (FR Left).STL
Rig-Assembly-Files/Printable STLs/Animal Box Assembly/Cage (Box) v1/Top Components/Keeper/Top Lock Keeper (FR Right).STL
Rig-Assembly-Files/Printable STLs/Animal Box Assembly/Cage (Box) v1/Top Components/Top Lock Pivot Mounts.STL
Rig-Assembly-Files/Printable STLs/Animal Box Assembly/Cage (Box) v2/Legs/Front Leg Left v2.1.stl
Rig-Assembly-Files/Printable STLs/Animal Box Assembly/Cage (Box) v2/Legs/Front Leg Right v2.1.stl
Rig-Assembly-Files/Printable STLs/Animal Box Assembly/Cage (Box) v2/Legs/Front Legs I v2.2.stl
Rig-Assembly-Files/Printable STLs/Animal Box Assembly/Cage (Box) v2/Legs/Front Legs II v2.2.3mf
Rig-Assembly-Files/Printable STLs/Animal Box Assembly/Cage (Box) v2/Legs/Front Legs II v2.2.stl
Rig-Assembly-Files/Printable STLs/Animal Box Assembly/Cage (Box) v2/Legs/Print All Cage Legs.3mf
Rig-Assembly-Files/Printable STLs/Animal Box Assembly/Cage (Box) v2/Legs/Rear Leg - Left.stl
Rig-Assembly-Files/Printable STLs/Animal Box Assembly/Cage (Box) v2/Legs/Rear Leg - Right.stl
Rig-Assembly-Files/Printable STLs/Animal Box Assembly/Cage (Box) v2/Legs/Rear Legs I v2.2.stl
Rig-Assembly-Files/Printable STLs/Animal Box Assembly/Cage (Box) v2/Pee Tray/pee tray alignment parts mirrored.STL
Rig-Assembly-Files/Printable STLs/Animal Box Assembly/Cage (Box) v2/Pee Tray/pee tray alignment parts.3mf
Rig-Assembly-Files/Printable STLs/Animal Box Assembly/Cage (Box) v2/Pee Tray/pee tray alignment parts.STL
Rig-Assembly-Files/Printable STLs/Animal Box Assembly/Cage (Box) v2/Pee Tray/pee tray corner 1.stl
Rig-Assembly-Files/Printable STLs/Animal Box Assembly/Cage (Box) v2/Top/Lock Keepers Type A/Top Lock Keepers v2.3.stl
Rig-Assembly-Files/Printable STLs/Animal Box Assembly/Cage (Box) v2/Top/Top Handle v2.stl
Rig-Assembly-Files/Printable STLs/Animal Box Assembly/Cage (Box) v2/Top/Top Handle.3mf
Rig-Assembly-Files/Printable STLs/Animal Box Assembly/Cage (Box) v2/Top/Top Handle.STL
Rig-Assembly-Files/Printable STLs/Animal Box Assembly/Cage (Box) v2/Top/Top Lock Latches v2.5.stl
Rig-Assembly-Files/Printable STLs/Animal Box Assembly/Cage (Box) v2/Top/Top Lock Latching Components v2.5.3mf
Rig-Assembly-Files/Printable STLs/Animal Box Assembly/Cage (Box) v2/Top/Top Lock Pivot Mount v2 (prints 4).3mf
Rig-Assembly-Files/Printable STLs/Animal Box Assembly/Old/Cage (Box) v1/Pee Tray/pee tray alignment parts.STL
Rig-Assembly-Files/Printable STLs/Animal Box Assembly/Old/Cage (Box) v1/Top Components/Cage Top Corner Pieces.3mf
Rig-Assembly-Files/Printable STLs/Animal Box Assembly/Old/Cage (Box) v1/Top Components/Keeper/Top Lock Keeper (FR Left).STL
Rig-Assembly-Files/Printable STLs/Animal Box Assembly/Old/Cage (Box) v1/Top Components/Top Handle.3mf
Rig-Assembly-Files/Printable STLs/Animal Box Assembly/Old/Cage (Box) v1/Top Components/Top Lock Latching Components.STL
Rig-Assembly-Files/Printable STLs/Animal Box Assembly/Old/Cage (Box) v1/Top Components/Top Lock Pivot Mounts.STL
Rig-Assembly-Files/Printable STLs/Other Components/Vac & Air tubing clamps-adapters-splitters/Barbed Fitting Spout Vac Adaptor 0.25in to 0.75in.3mf
Rig-Assembly-Files/Printable STLs/Other Components/Vac & Air tubing clamps-adapters-splitters/Barbed Fitting Spout Vac Adaptor 0.25in to 0.75in.stl
Rig-Assembly-Files/Printable STLs/Other Components/Vac & Air tubing clamps-adapters-splitters/Barbed Hose Fitting 0.25in to 0.75in for Vac-Spout Connection.3mf
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
