neuroMoth/3-Port-4-Bottle-Rig/Rig-Assembly-Files/Printable STLs/Animal Box Assembly/Cage (Box) v2/README.md

## Cage Components v2

This directory contains the parts used for the animal box. This includes 4 cage legs, lid corners, and the latches which lock the lid in place.

* open the .3mf file in PrusaSlicer.
* all settings will be set as needed, no need to modify unless these parts are found to be too weak. If so, infill percentage can be increased.
* click 'Slice Now' in the bottom right of the PrusaSlicer window.
* remove the usb from the front of the Prusa Core One 3D printer.
* plug the USB into your computer and wait for the USB icon to appear in the bottom right of the PrusaSlicer window.
* click the USB icon and then click save in the popup window that appears.
* re-insert the USB into the printer and click print when the print preview appears.
* wait until your print is complete.

All STL files are the individual parts that are included in the 3mf file. STL files can be loaded into software (e.g. Autodesk Fusion or SolidWorks) for modifying 3d models if a part needs to be edited. Individual STL models can be opened in PrusaSlicer but the print settings won't be included.
