neuroMoth/3-Port-4-Bottle-Rig/Rig-Assembly-Files/Printable STLs/Stimulus Delivery Frame/Delivery Frame Body/README.md

## Delivery Frame Body v2

Current as of 7/28/26. The "Z Post to Breadboard Mounts" are unaltered from v1, but the tower top brackets replace the x-axis components from v1 without the stepper motor. 

This directory contains the files used for the stimulus delivery frame body in the 3 port rig. The Z-posts connect the breadboard to the 10x100mm rods, and the frame tower tops connect the 10x100mm rods to the longer X-axis rods.

To print all the components you will need for one rig:

* open the .3mf file named 'ALL Frame Z-Posts' in PrusaSlicer.
* all settings will be set as needed, no need to modify unless these parts are found to be too weak. If so, infill percentage can be increased.
* click 'Slice Now' in the bottom right of the PrusaSlicer window.
* remove the usb from the front of the Prusa Core One 3D printer.
* plug the USB into your computer and wait for the USB icon to appear in the bottom right of the PrusaSlicer window.
* click the USB icon and then click save in the popup window that appears.
* re-insert the USB into the printer and click print when the print preview appears.
* wait until your print is complete.
* repeat with the frame tower top left and right bracket .3mf files. 

All other stl files are the individual components that make up the 3mf file and are useful if only one replacement part is needed.

In this case the above steps will be very similar. The major difference is that you will open PrusaSlicer to a blank file (shown by '\*Untitled' in the top left of the window and an empty print bed). You can then import your stl file by clicking 'File' in the left hand
corner of the window, then import, then stl/3mf/... You can then orient your part as you see fit, change settings, slice, and print!
