neuroMoth/3-Port-4-Bottle-Rig/Rig-Assembly-Files/Printable STLs/Valve and Stimulus Loading Frame/Syringe and Valve Holder v3/README.md

## Syringe and Valve Holder v3

This version was used to train and run TD10-TD15 until 7/18/26 (TVD). The stimuli were loaded in 20ml glass syringes and were delivered using Lee company solenoid valves. This holding frame was designed to fit into a large cooler as one piece. Some parts were updated during this period, so this folder contains some parts with multiple versions. 

This directory contains all the printable stl files for the stimulus and valve holding frame of the 3 port rig. To print components:

* open the .3mf file for the part you need in PrusaSlicer.
* all settings will be set as needed, no need to modify unless these parts are found to be too weak. If so, infill percentage can be increased.
* click 'Slice Now' in the bottom right of the PrusaSlicer window.
* remove the usb from the front of the Prusa Core One 3D printer.
* plug the USB into your computer and wait for the USB icon to appear in the bottom right of the PrusaSlicer window.
* click the USB icon and then click save in the popup window that appears.
* re-insert the USB into the printer and click print when the print preview appears.
* wait until your print is complete.

All other stl files are the individual components that make up the 3mf file and are useful if only one replacement part is needed.

In this case the above steps will be very similar. The major difference is that you will open PrusaSlicer to a blank file (shown by '\*Untitled' in the top left of the window and an empty print bed). You can then import your stl file by clicking 'File' in the left hand
corner of the window, then import, then stl/3mf/... You can then orient your part as you see fit, change settings, slice, and print!
