neuroMoth/3-Port-4-Bottle-Rig/Rig-Assembly-Files/Printable STLs/Stimulus Delivery Frame/Spout Assembly/README.md

## Spout Delivery Tube Alignment Tool

This stl file is used to align the many delivery tubes inside of the lick spout so
that they are evenly spaced from each other.

To print this component you will need to use a resin 3D printer to accurately print
the tiny holes for the delivery tubes.

The Teflon spacer can be printed with pla. It aligns the Teflon vac tube with the outside of the spout so that the vac is pulling equally around it.
