neuroMoth/3-Port-4-Bottle-Rig/Rig-Assembly-Files/Solidworks-Fusion CAD Files/Animal Box Assembly/v1/README.md

The only part files you will find here are under the Cage (Box) folder, other folders
only house assembly files that are only useful for viewing parts in context with 
parts they are mounted to or related to.
