neuroMoth/3-Port-4-Bottle-Rig/Rig-Assembly-Files/Solidworks-Fusion CAD Files/Stimulus Delivery Frame/v1/README.md

## Delivery Frame Components

This directory contains the 3D models of all components related to the delivery 
side of the 3 port rig. This is the structure on which the Teflon delivery tubes
mount during an experiment.
