neuroMoth/3-Port-4-Bottle-Rig/Rig-Assembly-Files/Printable STLs/Stimulus Delivery Frame/Doors/v2/README.md

## Spout Door (Linear Actuator) Components v2

Current as of 7/28/26 (TVD). This version has different center and lateral door mounts. Both now use the small rails to make movement more precise, but the center door also has connections for the spout waste vacuum during rinse. 

This directory contains all the printable stl files for the port doors used in the 3 port rig. This included the mount from the linear actuator to the breadboard, as well as the top bracket connecting the actuator to the aluminum door.

To print Linear Actuator components:

* open the .3mf file for the part you need in PrusaSlicer.
* all settings will be set as needed, no need to modify unless these parts are found to be too weak. If so, infill percentage can be increased.
* click 'Slice Now' in the bottom right of the PrusaSlicer window.
* remove the usb from the front of the Prusa Core One 3D printer.
* plug the USB into your computer and wait for the USB icon to appear in the bottom right of the PrusaSlicer window.
* click the USB icon and then click save in the popup window that appears.
* re-insert the USB into the printer and click print when the print preview appears.
* wait until your print is complete.

All other stl files are the individual components that make up the 3mf file and are useful if only one replacement part is needed.

In this case the above steps will be very similar. The major difference is that you will open PrusaSlicer to a blank file (shown by '\*Untitled' in the top left of the window and an empty print bed). You can then import your stl file by clicking 'File' in the left hand
corner of the window, then import, then stl/3mf/... You can then orient your part as you see fit, change settings, slice, and print!
