neuroMoth/3-Port-4-Bottle-Rig/Rig-Assembly-Files/Solidworks-Fusion CAD Files/Stimulus Delivery Frame/v1/Frame Towers - Frame Supports - Frame Posts/README.md

## Frame Supports

These are the components which hold the 10x100mm rods which hold the X-axis rods
(where the Teflon tubes mount) upright. The motor mount and idler mount connect 
to the breadboard via these rods.
