neuroMoth/3-Port-4-Bottle-Rig/Rig-Assembly-Files/Solidworks-Fusion CAD Files/Stimulus Delivery Frame/v1/Spout  to Delivery Frame Mounts/README.md

## Spout Delivery Frame Mounts 

These are the components which mount to the X-axis rods to position the Teflon 
tubes in the correct location to align with the lick ports. Additionally, the 
Teflon delivery tube components directory contains files related to mounting the 
Teflon tube to these components.
