neuroMoth/3-Port-4-Bottle-Rig/Rig-Assembly-Files/Solidworks-Fusion CAD Files/Stimulus Delivery Frame/v1/Spout Delivery Frame - X axis/README.md

## Delivery Frame - X-Axis Components

These components are those that connect to the breadboard via 2 10x100mm linear rods. 
They support the X-axis motor as well as the Idler to provide center port motion and provide a sturdy
x-axis through the use of 2 6x300mm linear rods.
