neuroMoth/3-Port-4-Bottle-Rig/Rig-Assembly-Files/Solidworks-Fusion CAD Files/Animal Box Assembly/v1/Cage (Box)/Pee Tray/README.md

## Pee Tray

All 3D models for the tray that attaches to the bottom of the rig box. These parts 
are not printable but are useful if changes need to be made to the CNC parts.
