neuroMoth/3-Port-4-Bottle-Rig/Rig-Assembly-Files/Solidworks-Fusion CAD Files/Animal Box Assembly/v1/Cage (Box)/Support Legs/README.md

## Support Legs 

These components are the support legs. They are the peices that join the acrylic walls
and aluminum faceplate together. There are four in total, on on each corner of the box.
