neuroMoth/3-Port-4-Bottle-Rig/Rig-Assembly-Files/Solidworks-Fusion CAD Files/Animal Box Assembly/v1/Cage (Box)/Walls/README.md

## Cage Walls

Here the models for each cage wall are stored. These are also not printable, but changes to CNC files can be made by 
making modifications to these model files, exporting the dxf (drawing) of a face, and
importing this drawing into carbide create.
