neuroMoth/3-Port-4-Bottle-Rig/Circuitry/signal-enhancer/signal-enhancer.kicad_pcb

## KiCad design Circuitry/signal-enhancer/signal-enhancer.kicad_pcb (2025-07-29)

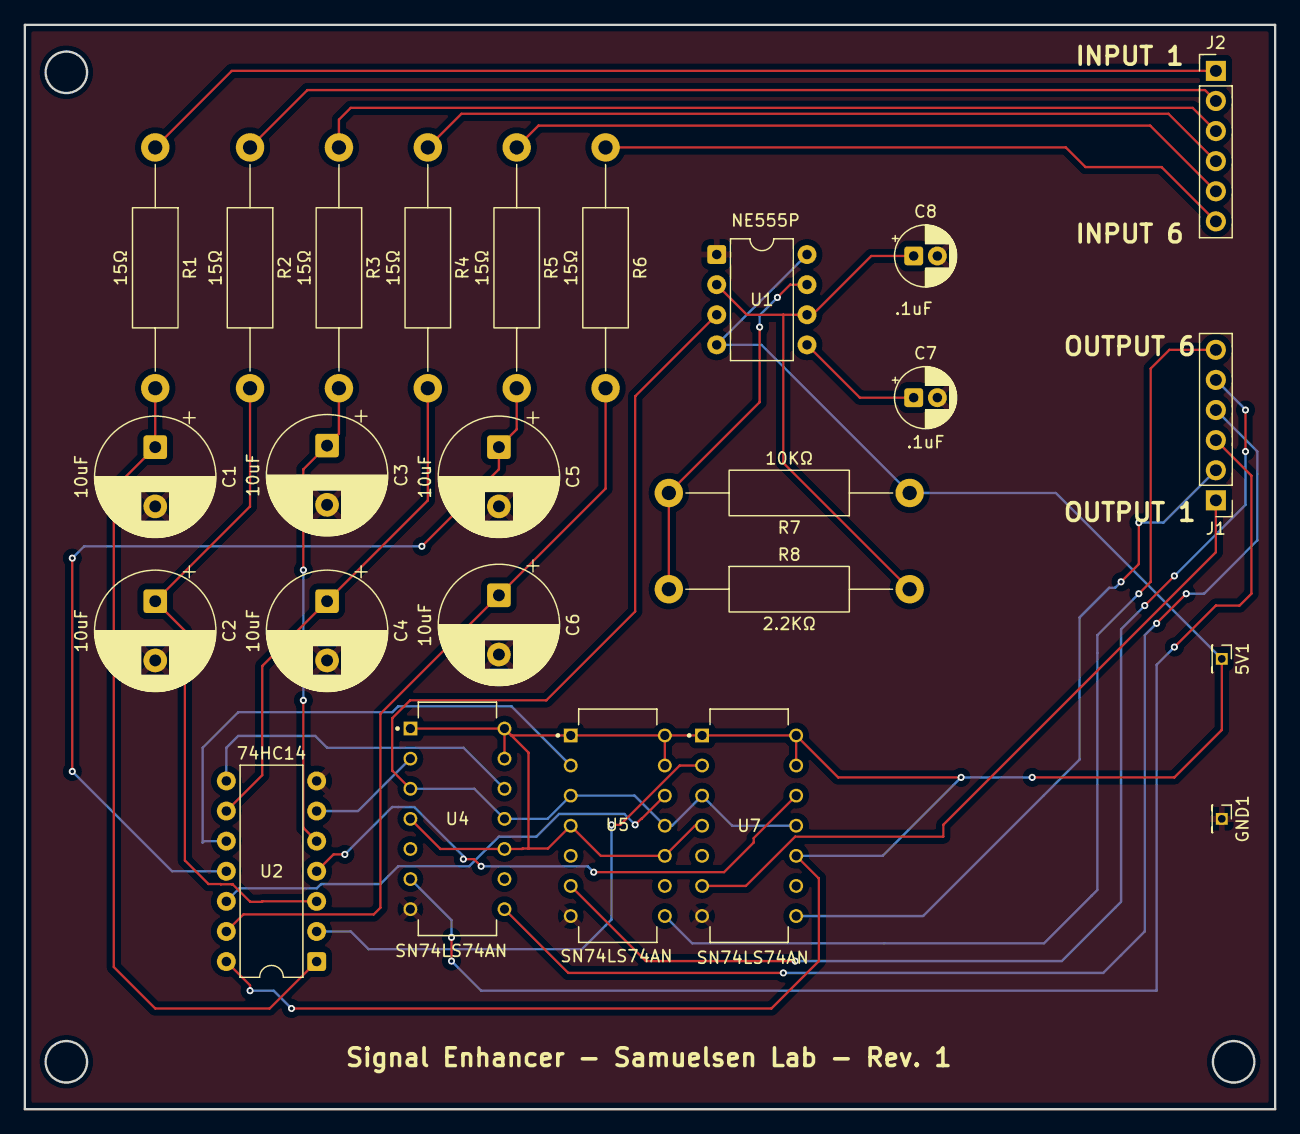
[picture p53: board signal-enhancer.kicad_pcb from above]

Board: 2 copper layers, 105.5 x 91.5 mm, 25 parts (0 on the bottom side), 30 nets.

Parts:
5V1: Conn_01x01_Pin; PinHeader_1x01_P1.27mm_Vertical
C1, C2, C3, C4, C5, C6: 10uF; CP_Radial_D10.0mm_P5.00mm
C7, C8: .1uF; CP_Radial_D5.0mm_P2.00mm
GND1: Conn_01x01_Pin; PinHeader_1x01_P1.27mm_Vertical
J1, J2: Conn_01x06_Pin; PinHeader_1x06_P2.54mm_Vertical
R1, R2, R3, R4, R5, R6: 15Ω; R_Axial_DIN0411_L9.9mm_D3.6mm_P20.32mm_Horizontal
R7: 10KΩ; R_Axial_DIN0411_L9.9mm_D3.6mm_P20.32mm_Horizontal
R8: 2.2KΩ; R_Axial_DIN0411_L9.9mm_D3.6mm_P20.32mm_Horizontal
U1: NE555P; DIP-8_W7.62mm
U2: 74HC14; DIP-14_W7.62mm
U4, U5, U7: SN74LS74AN

Connections:
/5V: 5V1.1, R7.1, U1.4 (R), U1.8 (VCC), U2.14 (VCC), U4.1 (1~CLR), U4.4 (1~PRE), U4.10 (2~PRE), U4.13 (2~CLR), U4.14 (VCC), U5.1 (1~CLR), U5.4 (1~PRE), U5.10 (2~PRE), U5.13 (2~CLR), U5.14 (VCC), U7.1 (1~CLR), U7.4 (1~PRE), U7.10 (2~PRE), U7.13 (2~CLR), U7.14 (VCC)
/555_CLK: U1.3 (Q), U4.3 (1CLK), U4.11 (2CLK), U5.3 (1CLK), U5.11 (2CLK), U7.3 (1CLK), U7.11 (2CLK)
/GND: C1.2, C2.2, C3.2, C4.2, C5.2, C6.2, C7.2, C8.2, GND1.1, U1.1 (GND), U2.7 (GND), U4.7 (GND), U5.7 (GND), U7.7 (GND)
/IN_1: J2.1, R1.1
/IN_2: J2.2, R2.1
/IN_3: J2.3, R3.1
/IN_4: J2.4, R4.1
/IN_5: J2.5, R5.1
/IN_6: J2.6, R6.1
/OUT_1: J1.1, U7.6 (1~Q)
/OUT_2: J1.2, U7.8 (2~Q)
/OUT_3: J1.3, U4.6 (1~Q)
/OUT_4: J1.4, U4.8 (2~Q)
/OUT_5: J1.5, U5.6 (1~Q)
/OUT_6: J1.6, U5.8 (2~Q)
/SCHM_1: C1.1, R1.2, U2.1
/SCHM_2: C2.1, R2.2, U2.3
/SCHM_3: C3.1, R3.2, U2.5
/SCHM_4: C4.1, R4.2, U2.9
/SCHM_5: C5.1, R5.2, U2.11
/SCHM_6: C6.1, R6.2, U2.13
/pin_5: C7.1, U1.5 (CV)
/pin_6_to_2: C8.1, R8.2, U1.2 (TR), U1.6 (THR)
/r7_to_pin-7: R7.2, R8.1, U1.7 (DIS)
unnamed: U2.6, U4.2 (1D)
unnamed: U2.8, U4.12 (2D)
unnamed: U2.10, U5.2 (1D)
unnamed: U2.12, U5.12 (2D)
unnamed: U2.2, U7.2 (1D)
unnamed: U2.4, U7.12 (2D)
