neuroMoth/3-Port-4-Bottle-Rig/Circuitry/valve-driver/valve-driver/valve-driver.kicad_pcb

## KiCad design Circuitry/valve-driver/valve-driver/valve-driver.kicad_pcb (2025-07-29)

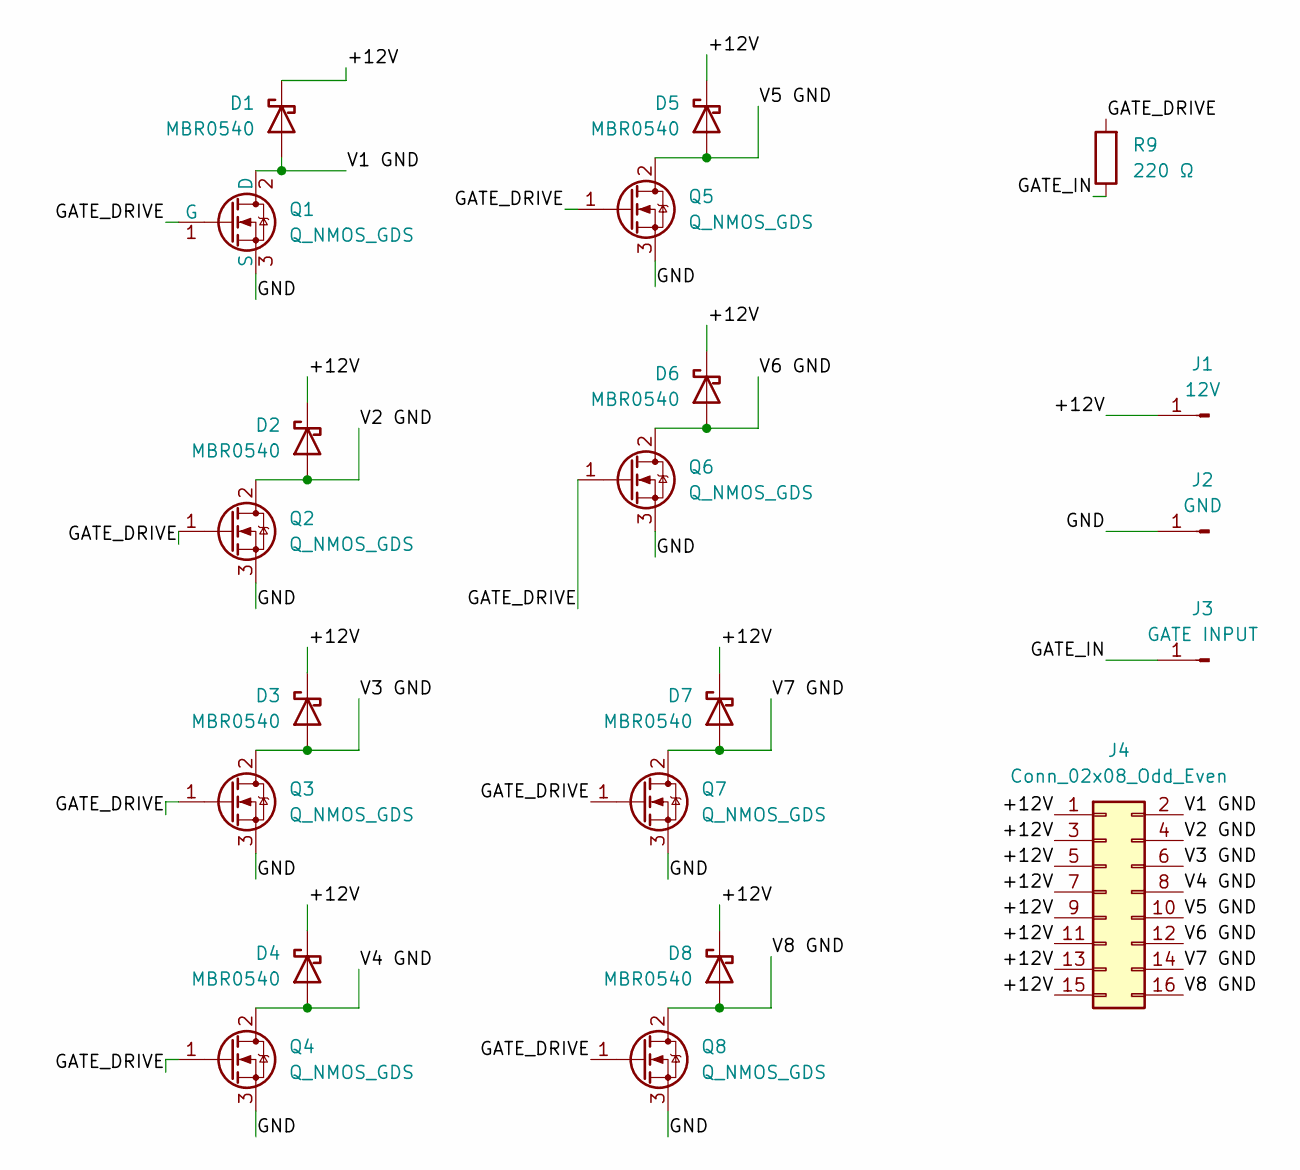
[picture p54: schematic valve-driver.kicad_sch]

Parts:
D1, D2, D3, D4, D5, D6, D7, D8: MBR0540; D_DO-15_P15.24mm_Horizontal
J1: 12V; PinHeader_1x01_P2.54mm_Vertical
J2: GND; PinHeader_1x01_P2.54mm_Vertical
J3: GATE INPUT; PinHeader_1x01_P2.54mm_Vertical
J4: Conn_02x08_Odd_Even; PinHeader_2x08_P2.54mm_Vertical
Q1, Q2, Q3, Q4, Q5, Q6, Q7, Q8: Q_NMOS_GDS; TO-220-3_Vertical
R9: 220 Ω; R_Axial_DIN0309_L9.0mm_D3.2mm_P15.24mm_Horizontal

Connections:
/+12V: D1.1 (K), D2.1 (K), D3.1 (K), D4.1 (K), D5.1 (K), D6.1 (K), D7.1 (K), D8.1 (K), J1.1, J4.1, J4.3, J4.5, J4.7, J4.9, J4.11, J4.13, J4.15
/GATE_DRIVE: Q1.1 (G), Q2.1 (G), Q3.1 (G), Q4.1 (G), Q5.1 (G), Q6.1 (G), Q7.1 (G), Q8.1 (G), R9.2
/GATE_IN: J3.1, R9.1
/GND: J2.1, Q1.3 (S), Q2.3 (S), Q3.3 (S), Q4.3 (S), Q5.3 (S), Q6.3 (S), Q7.3 (S), Q8.3 (S)
/V1 GND: D1.2 (A), J4.2, Q1.2 (D)
/V2 GND: D2.2 (A), J4.4, Q2.2 (D)
/V3 GND: D3.2 (A), J4.6, Q3.2 (D)
/V4 GND: D4.2 (A), J4.8, Q4.2 (D)
/V5 GND: D5.2 (A), J4.10, Q5.2 (D)
/V6 GND: D6.2 (A), J4.12, Q6.2 (D)
/V7 GND: D7.2 (A), J4.14, Q7.2 (D)
/V8 GND: D8.2 (A), J4.16, Q8.2 (D)

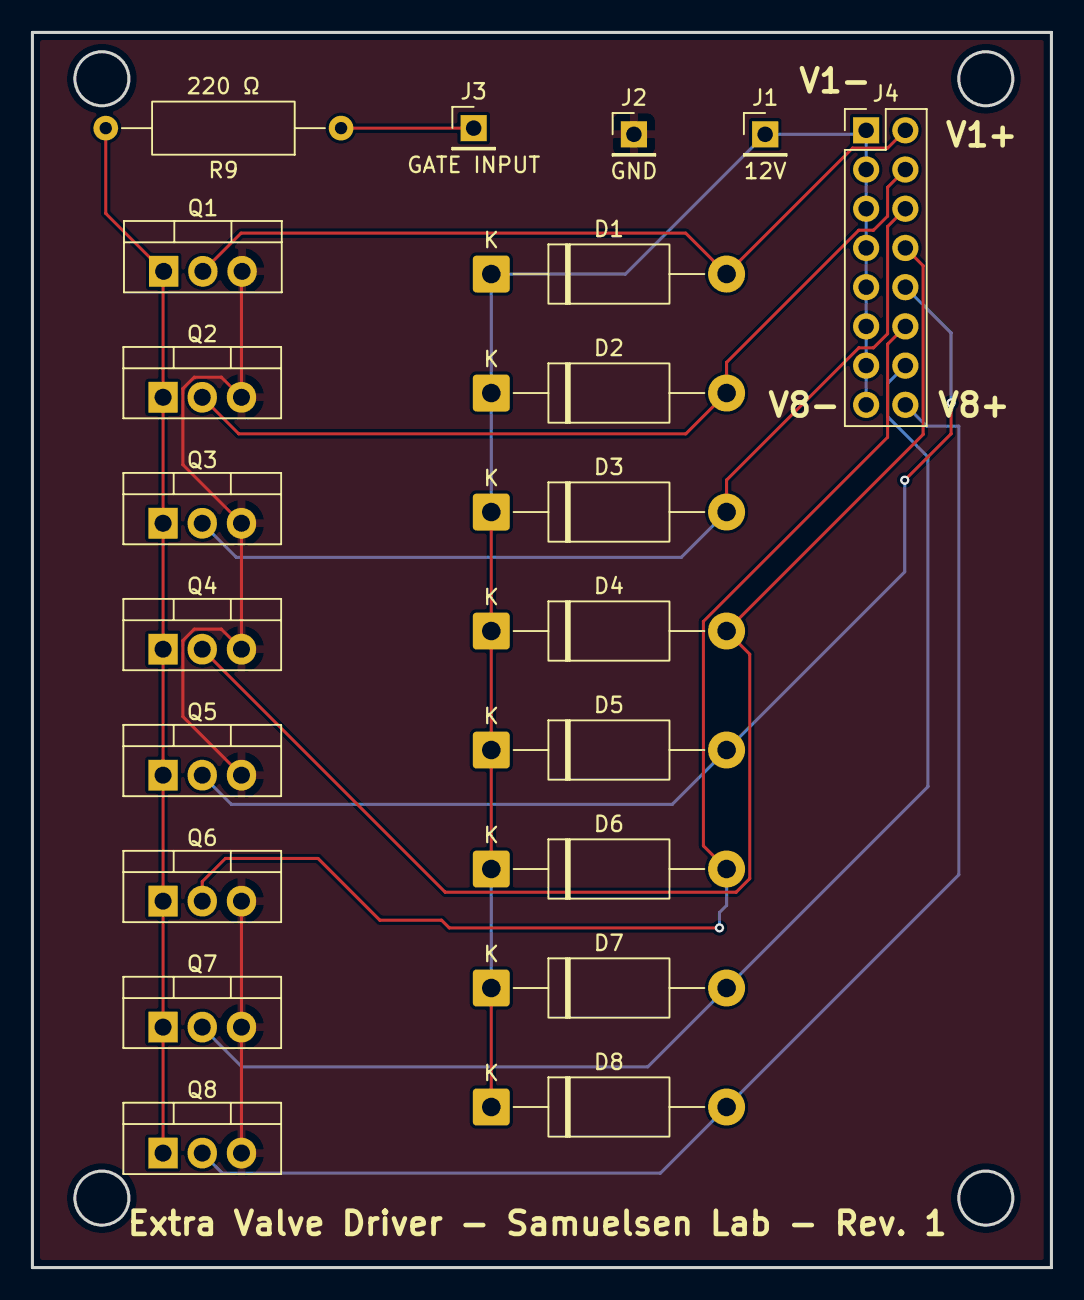
[picture p55: board valve-driver.kicad_pcb from above]

Board: 2 copper layers, 66.0 x 80.0 mm, 21 parts (0 on the bottom side), 12 nets.
