neuroMoth/3-Port-4-Bottle-Rig/(commit log)

2025-05-14 first commit, faceplate for motion bracket
    [3 port faceplate - fused for motion bracket.dxf]
2025-05-15 add stl for new 2-port-mount-cap
    [Back Acrylic.dxf, SIDE WALLS.DXF, cage top.dxf, facepate-mount-cap.stl]
2025-05-19 c2d files for acryllic box
    [Front Legs.step, Single Spout Faceplate Mount.step, Teflon holder bracket.stl, facepate-mount-cap.stl, faceplate mount.stl, spout-faceplate-mount.stl, x-end-idler-r2.stl, x-end-motor-r2.stl]
2025-05-22 main faceplate c2d
    [Main Cage Faceplate 3 Port Rig.dxf, Teflon Tube (Spout) Mouting Fixture - Angle and Height Adjustment bracket (HEAT INSERT).STEP]
2025-05-22 spout door c2d
    [Spout Doors.dxf]
2025-06-26 teflon tube vac hole tool
    [Teflon Tube Vac Hole Tool.SLDPRT, Teflon Tube Vac Hole Tool.STL]
2025-07-11 add initial motor controlling code, printable gantry leg mount piece
    [3 port rig left leg mount.stl, Cage Legs - 2 Port Rig.stl, Cylinder Holder.SLDASM, Front Legs.stl, Part3.SLDPRT, Part4.SLDPRT, Port Door 3 Port Rig side.DXF, Port Door 3 Port Rig.DXF]
2025-07-14 motor arduino init
2025-07-15 clean up and clarify, group motor information
2025-07-16 linear actuators functioning properly, reset procedure on arduino startup
    [motorInfo.cpp, motorInfo.h, motor_controller.ino]
2025-07-18 move valve open time logic to function
2025-07-18 begin grouping valve info in class
2025-07-24 Add electronics box and cylinder holder CAD/STL files
    Added new SolidWorks part and assembly files for the electronics box and cylinder holder, including rough models for capacitive touch, linear motor driver, and stepper driver. Also included corresponding printable STL files for 3D printing and a reference image for the Arduino Mega enclosure.
    [ArduinoMega.SLDPRT, Part1.SLDPRT, capacitive-touch-rough-model.SLDPRT, electronics-box - ArduinoMega-1.STL, electronics-box - Part1-1.STL, electronics-box - capacitive-touch-rough-model-2.STL, electronics-box - capacitive-touch-rough-model-3.STL, electronics-box - capacitive-touch-rough-model-4.STL]
2025-07-24 Add cylinder holder CAD and STL files
    Added new SolidWorks part and assembly files for the cylinder holder, along with the corresponding printable STL file. Removed temporary and backup files to clean up the directory.
    [Cylinder Holder.SLDASM, cylinder holder.SLDPRT, cylinder holder.STL]
2025-07-28 Add valve holder and update cylinder holder CAD files
    Introduced new valve-holder assembly and plate files. Updated several cylinder holder part and assembly files to reflect design changes.
    [Cylinder Holder-bottom.SLDPRT, Cylinder Holder.SLDASM, Part3.SLDPRT, cylinder holder.SLDPRT, valve-holder-plate.SLDPRT, valve-holder.SLDASM]
2025-07-28 Add signal enhancer files and update CAD models
    Added new KiCad project files, backups, and cache for the signal enhancer circuitry. Updated and added several CAD files for the cylinder holder and valve holder assemblies, and included new printable STL files for the cylinder holder. Removed temporary and autosave files from the assembly directories.
    [Cylinder Holder.SLDASM, Part3.SLDPRT, Part7.SLDPRT, cylinder-holder-bottom.STL, cylinder-holder-top.STL, signal-enhancer.kicad_pcb, signal-enhancer.kicad_sch, valve-holder-plate.SLDPRT]
2025-07-29 Update PCB layout and connector footprints
    Modified component values to include Ω symbols and moved value layers to F.SilkS for better visibility. Updated positions of several components and changed connector footprints from 1.27mm to 2.54mm pitch for J2 and related connectors. Added new backup and PCB zip files, removed obsolete autosave and lock files, and added new STL files for valve bracket and holder plate.
    [signal-enhancer.kicad_pcb, signal-enhancer.kicad_sch, valve-bracket.STL, valve-holder-plate.STL]
2025-07-29 Update valve-driver and signal-enhancer PCB files
    Added new KiCad project files and backups for valve-driver. Updated signal-enhancer PCB and backup files. Modified several CAD and STL files for cylinder holder and valve-holder components.
    [Cylinder Holder.SLDASM, Part7.SLDPRT, Part7.STL, signal-enhancer.kicad_pcb, valve-bracket.STL, valve-driver.kicad_pcb, valve-driver.kicad_sch, valve-holder-plate.SLDPRT]
2025-07-29 Add gantry and spout mount CAD and STL files
    Added new STEP, SLDPRT, and STL files for gantry components and spout mounts, including center and edge spout mounts, Teflon tube holder bracket, and x-end motor/idler parts. These files support the mechanical design and 3D printing of updated gantry assemblies.
    [Center Spout Mount .step, Teflon holder bracket.step, center-spout-mount-cap.step, edge-spout-mount-caps.step, edge-spout-mounts.step, x-end-idler-r5.SLDPRT, x-end-idler-r5.STL, x-end-idler-r5.step]
2025-07-31 Add cage top and spout mount CAD/CNC files
    Added new CNC, DXF, STEP, SLDASM, SLDPRT, STL, and 3MF files for cage top with screws, cage assembly, spout mounts, and related components. Updated valve driver backup and modified cylinder holder assembly and parts. These changes support new rig assembly and printable components.
    [BACK ACRYLLIC 3 PORT RIG.step, CAGE TOP 3 PORT RIG.step, Cage Assembly.SLDASM, Center Spout Mount .STL, Center Spout Mount.SLDPRT, Cylinder Holder.SLDASM, Main Cage Faceplate 3 port rig.step, Part2.SLDPRT]
2025-07-31 Update cylinder holder CAD files and add stencil part
    Modified several Cylinder Holder CAD files and the corresponding STL. Added a new stencil.SLDPRT part. Removed multiple temporary and backup files to clean up the directory.
    [Cylinder Holder.SLDASM, Part7.STL, cylinder holder pressure top.SLDPRT, cylinder holder.SLDPRT, cylinder holder.STL, stencil.SLDPRT]
2025-07-31 Update electronics box CAD part and assembly files
    Modified Part1.SLDPRT and electronics-box-asm.SLDASM files for the electronics box.
    [Part1.SLDPRT, electronics-box-asm.SLDASM]
2025-08-05 solidworks updates & stls
    electronics box, screw based assembly for box, etc
    [BACK ACRYLLIC 3 PORT RIG.SLDPRT, BACK ACRYLLIC 3 PORT RIG.step, Cage Assembly.SLDASM, Cage Rear Leg - left.SLDPRT, Cage Rear Leg - right.SLDPRT, Cage Rear Leg - right.STL, Cage Rear Leg.step, Front Leg - Left.SLDPRT]
2025-08-05 Add and update CAD and STL files for cage and spout mounts
    Added new CAD and STL files for cage alignment (large and small) and Teflon holder bracket. Removed obsolete STEP and SLDPRT files for spout mounts and gantry components, and updated file organization and naming for clarity.
    [Cage Alignment Large.SLDPRT, Cage Alignment Large.STL, Cage Alignment small.SLDPRT, Cage Alignment small.STL, Center Spout Mount .step, Linear Actuator Mount.SLDPRT, Linear Actuator Mount.STL, Rack - Bearing Holder.stl]
2025-08-05 change center port structure
    change center port structure so that the back mounting piece and the front mounting piece are separated for easier printing
    [Center Spout Mount-bearing-mount.SLDPRT, Center Spout Mount.SLDPRT, center-spout-mount assembly - Center Spout Mount-1.STL, center-spout-mount assembly - Center Spout Mount-bearing-mount-2.STL, center-spout-mount assembly.SLDASM]
2025-08-06 add bpod local to move protocols
    [3-port-rig.SLDASM, MB2424-Solidworks.sldprt, Part3.SLDPRT, gantry leg mounts.step, single spout mount.stl, x-end-idler-r5.step, x-end-motor-r5.step]
2025-08-07 clean up stl file structure, update solidworks files
    solidworks updates include the teflon mount bracket, and linear actuator bracket
    [Cage Legs - 2 Port Rig.stl, Front Legs.stl, Spout Door Rack Gear.stl, Teflon Tube (Spout) Mouting Fixture - Angle and Height Adjustment bracket.SLDPRT, Teflon Tube (Spout) Mouting Fixture - Angle and Height Adjustment bracket.STL, barrel.stl, cylinder base.STL, cylinder holder base.STL]
2025-08-11 Add new CAD and STL files for rig assembly
    Added several new DXF, SLDPRT, SLDASM, and STL files for the rig assembly, including cage components, top handle, rear and front legs, and glass syringe pressurizer. Updated existing CAD files and removed obsolete or temporary files to reflect the latest design changes.
    [BACK ACRYLLIC 3 PORT RIG.DXF, Cage Assembly.SLDASM, Cage Bottom (pee tray).DXF, Cage Bottom (pee tray).SLDPRT, Cage Rear Leg - left.SLDPRT, Cage Rear Leg - right.SLDPRT, Cage Rear Legs.STL, Cylinder Holder.SLDASM]
2025-08-12 Add CNC and CAD files for pee tray and cylinder holder
    Added new .c2d files for pee tray extrusions and several temporary SolidWorks files for the cylinder holder assembly. Updated the cylinder holder STL file.
    [cylinder holder.STL]
2025-08-12 Add pee tray Y-axis extrusion CAD and CNC files
    Added new C2D and DXF files for the pee tray Y-axis extrusion. Introduced corresponding SolidWorks part files for the pee tray extrusions (angled, X-axis, Y-axis). Updated cage bottom and cylinder holder CAD files, removed temporary SolidWorks files, and relocated a valve-holder temp file.
    [Angled Extrusion.SLDPRT, Cage Bottom (pee tray).SLDPRT, Cylinder Holder.SLDASM, X-Axis Extrusion.SLDPRT, Y-Axis Extrusion.DXF, Y-Axis Extrusion.SLDPRT, cylinder holder.SLDPRT]
2025-08-12 Add pee tray alignment parts and update STL/3MF files
    Added new CAD and STL files for pee tray alignment parts and a 3MF assembly with alignment pieces. Removed temporary or backup SolidWorks files from the Cage and Pee Tray directories.
    [Top Lock Keeper Assemblies ALL FOUR with pee tray alignment pieces.3mf, pee try alignment parts.SLDPRT, pee try alignment parts.STL]
2025-08-12 Update CNC and 3D model files for pee tray assembly
    Modified the C2D files for pee tray x and y axis extrusions and updated the 3MF file for the top lock keeper assemblies with pee tray alignment pieces. These changes likely reflect design adjustments or improvements to the pee tray assembly components.
    [Top Lock Keeper Assemblies ALL FOUR with pee tray alignment pieces.3mf]
2025-08-18 begin side training day 5, finish day 3
    finshed day 3 protocol, began day 5. discovered that timers are
    triggered as output actions not when the state is finished, but when it
    starts. Therefore, moving lick timer beginning to after first lick
    states.
2025-08-21 finish alternation day one and prepare for random trials
    finished alternation and switched to 'correct' and 'incorrect' port
    selection model that is top down (center chosen first) rather than the
    other way around which made no sense. This will make the random script
    much easier to write.
2025-08-25 finish random day 1 and 2
    completed generation of the pseudorandom center port valve selection
    function and reduced ttc for both center and lateral ports. Next will
    clean up previous protocols with class based structure.
2025-08-25 update motor controller code. increase motor movement time.
    increase motor movement time. using previous time, any slight resistance
    to motor movement will result in motor not moving far enough during its
    travel time to reach the desired destination. increasing travel time
    should allow motor to overcome this resistance.
2025-08-25 Add new CAD and CNC files for rig assembly
    Added multiple new SolidWorks, DXF, C2D, STEP, and STL files for various rig assembly components, including vac splitter, pee tray, barrier strip covers, gantry post mounts, and hose adapters. Updated several existing CAD and STL files to reflect design changes.
    [1 to 8 vac splitter.SLDPRT, 1 to 8 vac splitter.STL, 8.5mm to 4.8mm hose adapter.SLDPRT, 8.5mm to 4.8mm hose adapter.STL, Cage Assembly.SLDASM, Cage Bottom (pee tray).DXF, Cage Bottom (pee tray).SLDPRT, Linear Actuator Mount - ALL THREE.3mf]
2025-09-08 valve driver case
    [Teflon Tube (Spout) Mouting Fixture - Angle and Height Adjustment bracket.SLDPRT, valve-driver.SLDASM]
2025-09-08 valve driver step
    [Main Cage Faceplate 3 Port Rig.dxf, Teflon Tube (Spout) Mouting Fixture - Angle and Height Adjustment bracket.3mf, Teflon Tube (Spout) Mouting Fixture - Angle and Height Adjustment bracket.STL, cylinder holder pressure top.SLDPRT, cylinder holder pressure top.STL, holder_elevator^Cylinder Holder.STL, linear-actuator-door-bracket.STL, new-barrel-3.STL]
2025-09-08 Clean up file structure
    remove outdated files, consolidate duplicate folders and files, clean up file structure for clarity
    [1 to 8 vac splitter.SLDPRT, 1 to 8 vac splitter.STL, 3 port rig left leg mount.stl, 3-port-rig.SLDASM, 8.5mm to 4.8mm hose adapter.SLDPRT, 8.5mm to 4.8mm hose adapter.STL, Angled Extrusion.SLDPRT, ArduinoMega.SLDPRT]
2025-09-09 add misc c2d, new teflon spout ring
    [Teflon Tube Spout Clamp - SET OF FOUR.3mf, case cover.SLDPRT, case cover.STL, electronics-box-asm.SLDASM]
2025-09-12 Edits to alternation_6
    Mostly the same changes as for alternation_8, plus a few changes to printing trial info to the command line.
2025-09-13 A couple more changes to alternation_4
    Changed disengage condition. Added data field to structure to make results easier to read.
2025-09-14 Edits to alternation_2, punish after tup for lateral ports and printing to command window
    Punish after time up for lateral, increase disengagement to 20, and some additional changes to make it easier to read progress in the command window.
2025-09-16 New syringe mount complete and signal pcb case
    Completed new syringe mount
    [100 mm rod.SLDPRT, Cylinder Holder.SLDASM, Mount Bottom Mirror.SLDPRT, Mount Bottom Mirror.STL, Mount Bottom.SLDPRT, Mount Bottom.STL, Mount Mirrored.SLDPRT, Mount Mirrored.STL]
2025-09-16 readme for alignment parts
    [ALL Cage Alignment Components.3mf]
2025-09-17 remove old cylinder holder, finish cage stl docs
    [ALL Cage Top Components.3mf, All Cage Legs.3mf, Base.SLDPRT, Base.STL, Cage Assembly.SLDASM, Cage-Box Top.SLDPRT, Cage-Box Top.STL, Cylinder Holder.SLDASM]
2025-09-17 Random Training 1 Changes
    Punish after lateral TTC, printing to command line.
2025-09-17 Alternation 8 and 6 nonconsecutive
    Minor changes to trials skipped and printing to command window.
2025-09-18 add spout drain assembly parts
    built assembly to mount spouts in during draining procedure to reduce likelihood of valve damage.
    [10x100mm Linear Rod Clamp.SLDPRT, 10x100mm rod.SLDPRT, 3-port-rig.SLDASM, 6x300mm rod.SLDPRT, All Teflon Insert Anti-Valve-Leak.3mf, BACK ACRYLLIC 3 PORT RIG.SLDPRT, Base Connecting Rail.SLDPRT, Cage Assembly.SLDASM]
2025-09-18 update rod connector
    fix rod connector, holes were too small and damage was caused when tightening screws
    [Entire Spout Drain Assembly - All Required Parts.3mf, Spout Drain Assembly - rod connector-1.STL, Spout Drain Assembly - rod connector-2.STL, Spout Drain Assembly.SLDASM, rod connector.SLDPRT, rod connector.STL]
2025-09-18 Minor edits to side training day 7
    Add punish. Fix center valve time.
2025-09-20 Alternation edits: 10s ITI and reward 6th center lick
    10s ITI, reward 6th center lick, and some other minor changes to printing to command window.
2025-09-23 random_training_1 timing edits
    15s ITI, 10s punish, reward 6th lick in the center port, and a couple minor output print changes.
2025-09-25 Adding Protocol: Attempt at Alternation Protocol with Shuffling # Correct to Switch
    First attempt at protocol where the number of nonconsecutive correct trials required to switch center stimulus is randomly selected from an array in expV.
2025-10-02 Test edit for random training 2 - consistent blank timings
    For testing with the rig. We want the blanks to have the same opening time for all valves.
2025-10-02 Edits made while testing new blank timings
    Converting time to ms for valve timings.
2025-10-02 Adding random variance to blank timings for every opening.
    Make valves open within a range of +/- 10 ms for every valve opening to prevent any auditory cueing.
2025-10-03 Trying to add blank valve opening adjustments to testing protocol
    Trying to incorporate tested edits from random training 2 to the testing protocol. Disconnect blank valve opening from true valve opening but also adding random variance.
2025-10-03 Adding ITI and other updates from testing protocol to the random training 2 protocol
    Splitting ITI to save licktimes to the correct trial. Changing how engagement and corrects are counted and saved. Adding blank opening time changes to the lateral valve openings. Etc...
2025-10-06 Saving experimental variables as a table
    Previous method of saving current experimental variables actually didn't save the static values.
2025-10-08 Returning functionality for valves 3, 4, 6, and 7
    Now testing and random training 2 protocol scripts use all 8 valves to prevent rats learning to distinguish from the spout positions.
2025-10-18 Adjusting blank times
    Slight increase to blank open times to make them closer to the true valve times.
2025-10-23 Adding new clamp for holding vac tubing to teflon on the spout.
    Edited version of the clamp for holding on to the spout on the delivery frame.
    [Spout Vac Tube to Teflon Clamp.step]
2025-12-06 Attempt at having a single valve opening, plus edit to protocol settings
    Editing states in the experimental protocol to have a single valve opening for center and correct lateral instead of 3x each per trial. Also edited some values to see if they allow selecting 30ul of stimulus.
    Also, some adjustments to blank valve jitter.
2025-12-08 Couple minor fixes to single valve opening protocol
2025-12-09 Combine pseudorandom trial lineup and jitter generation into a single function. Timing improvements to single valve open protocol.
    Adjusted timing so that door has a brief delay after valve closes before going up. Randomization of blank valves, reward licks, and reward delay combined and streamlined in a single function.
2025-12-10 Moving around old files, renaming current set_parameters protocol, improvements and adjustments to single valve open protocol.
    Made some fixes to the timing and jitter. Reorganized so that some old files are no longer in the way. Renamed the current Set_exp_parameters protocol to separate from RV's version.
2025-12-11 Reorganizing single valve opening protocol
    Added some comments to explain functions. Reorganizing sections to make it easier to understand and edit.
2025-12-12 Adding a couple of the new 3d printed parts
    Spout vac connector and tubing clamps.
    [Barbed Hose Fitting 0.25in to 0.75in for Vac-Spout Connection.stl, Spout+Valve Tubing Clamp v6.stl]
2025-12-12 Top latch files
    From photologic rig github
    [Top Lock Latching Components.STEP]
2025-12-19 Small edits to one valve opening protocol delays and session end summary
2026-01-09 edits in progress - moving computer
    [Spout Vac Tube to Teflon Clamp v3.stl, Top Lock Keepers - TVD Edit3.stl, Top Lock Latching Components - TVD Edit4.stl, Top Lock Latching Components - TVD Edit5.stl]
2026-01-13 Moving old protocols to a new folder. Adding prototype for the new testing protocol.
    No more blanks and updated trial randomization script with max repeats per side and reduced combination repeats for valve, dry licks, and reward delay.
2026-01-13 Additional adjustments to valve order randomization. Adjusted softcode for reporting engaged trials.
    Now valves can't repeat more than twice even if the same side repeats more, as long as there are enough valves. Engagement reporting should be more accurate.
2026-01-13 Couple more small modifications to trial randomization.
    Making sure the selection of trial values stays balanced.
2026-01-14 Copied and renamed testing water left odor right v2 protocol to track changes for new training protocols.
    Testing and random v2 protocols are functional. Alternating and side training protocols have not been edited aside from renaming.
2026-01-15 New alternation protocol (test1)
    New method for switching between stimuli which allows for randomized valve, # dry licks, and valve delay.
2026-01-15 A few adjustments to get alternation to work.
    Made a couple silly mistakes which were easy to fix. Also fixed some reporting issues for engagement. NOTE: adjust how lateral dry licks are treated when incorrect. Right now seems to be short.
2026-01-19 Adding files for new valve/syringe holder frame parts.
    Now syringe and valve holder v3 is the current version with my (TVD) part designs.
    [10x100mm Linear Rod Clamp v3 - TVD edit.step, 10x100mm Linear Rod Clamp v3.stl, Clamp to Base Bracket v3 - TVD edit1.step, Clamp to Base Bracket v3 - TVD edit1.stl, Spout Vac Tube to Teflon Clamp v3.stl, Teflon Tube Vac Hole Tool.SLDPRT, Teflon Tube Vac Hole Tool.STEP, Top Lock Keepers - TVD Edit3.stl]
2026-01-19 Prototype for v2 side training protocol.
    This version is designed to incorporate subject-dependent session parameters.
2026-01-19 Success with prototype side training v2. Delete old prototype and copy to start work on protocols for side training 1 and 2.
2026-01-22 Adjustments to printing pee tray alignment parts
    [pee tray alignment parts.3mf]
2026-01-22 PortHandler accepts list of water and odor valves and assigns correct and incorrect ports. Incorrect trials still count as engaged.
    Case needed to be formatted by num2cell
2026-01-27 Edit to testing v2 to update valve times at the start of a session
2026-01-28 Condition selection with Set_exp_parameters and edit to testing valve time update
2026-02-14 Adding STLs for updated syringe/valve holder components
    Also some reorganizing in rig assembly STLs. Version 3 = components I (TVD) heavily modified or made for the current frame (for sound dampening).
    [1 to 8 vac splitter.STL, 8.5mm to 4.8mm hose adapter.STL, Barbed Hose Fitting 0.25in to 0.75in for Vac-Spout Connection.stl, Base Connecting Frame Bar (L).stl, Base Connecting Frame Bar (R).stl, Clamp to Base Bracket v3.stl, Full Electronics Shield.stl, Pressure Stopper Cap.stl]
2026-02-16 Prototype general testing 2OC task protocol using subject data to determine correct condition
2026-02-16 Revert "Prototype general testing 2OC task protocol using subject data to determine correct condition"
    This reverts commit 65c28494c1033f4e30bb4e9929bbb9810c4f4b7d.
2026-02-17 Reapply "Prototype general testing 2OC task protocol using subject data to determine correct condition"
    This reverts commit ce4f8c4486ba6a98685f69c7534e9cf9a0baad82.
2026-02-23 Reorganizing current protocol files
2026-02-24 Update session summary to calculate estimate consumed with 40ul per correct
2026-02-24 Updated side training protocol to test
    [pee tray alignment parts.3mf]
2026-02-24 Updated cage leg STL files
    [Cage Rear Leg - left - tvd edit1.stl, Cage Rear Leg - right - tvd edit1.stl, Front Leg - Left.stl, Front Leg - Right.stl, Print All Cage Legs.3mf]
2026-02-25 The rest of the updated v2 side training protocols
    Plus a few updated printing files for cage components
    [Print All Cage Legs.3mf, Top Lock Keepers - TVD Edit3.3mf, Top Lock Latching Components - TVD Edit5.3mf]
2026-02-26 Add: valve priming and dry lick skip after 5 second break from licking for day02 familiarization
    [Print All Cage Legs.3mf]
2026-02-26 Adding lick familliarization changes for day02 to day03
    Prime valve at the start of session and reset dry licks after a 5 sec break from licking.
2026-03-01 Updating some print and stl files for cage components and pressure cap
    [Barbed Hose Fitting 0.25in to 0.75in for Vac-Spout Connection.3mf, Pressure Stopper Cap.stl, Print All Cage Legs.3mf, Teflon Tube Spout Clamp - SET OF FOUR.3mf, Top Lock Keepers - TVD Edit3.3mf, Top Lock Latching Components - TVD Edit5.3mf, linear-actuator-door-bracket.3mf, pee tray alignment parts.3mf]
2026-03-02 Adding to general functions for protocols. More reorganizing and updating of print and stl files.
    [8.5mm to 4.8mm hose adapter.SLDPRT, 8.5mm to 4.8mm hose adapter.STEP, 8.5mm to 4.8mm hose adapter.STL, ALL Cage Alignment Components.3mf, ALL Cage Top Components.3mf, All Cage Legs.3mf, Barbed Hose Fitting 0.25in to 0.75in for Vac-Spout Connection.3mf, Barbed Hose Fitting 0.25in to 0.75in for Vac.step]
2026-03-04 Trying to add experiment timer that actually works
2026-03-04 Stop experiment and update valve times are now general functions
2026-03-04 Adding experiment timer update to the rest of the side training protocols. Adding 8s ITI for last two days of side training.
2026-03-04 Removing extra instances of update valve and stop experiment functions
2026-03-08 Adding fixed experiment timer to all protocols (except lick familiarization)
    Now we have an experiment timer that works. I can remove the nonfunctional one later.
2026-03-09 All Doors Down opens settings window to control valves
2026-03-13 Updated cage leg printing files + reorganizing delivery frame rig part files
    [ALL Linear Actuator Components.3mf, Cage Rear Leg Left v2.1.stl, Cage Rear Leg Right v2.1.stl, Door Alignment.step, Door Alignment.stl, Front Leg - Left.stl, Front Leg - Right.stl, Front Leg Left v2.1.stl]
2026-03-16 More adjustments to printing cage legs and door alignment parts
    [Cage Rear Leg Left v2.1.stl, Cage Rear Leg Right v2.1.stl, Door Alignment.stl, Print All Cage Legs.3mf, Rear Leg - Left.stl, Rear Leg - Right.stl, Spout2Valve Tubing Clamp 8 Ch.step, Spout2Valve Tubing Clamp 8 Ch.stl]
2026-03-18 Removing old fake experiment timer
2026-03-22 Adding updated delivery frame spout clamp and mounting bracket
    [Teflon Tube Spout Clamp - SET OF FOUR.3mf, Teflon Tube Spout Clamp v1.STL, Teflon Tube Spout Clamp v2.stl, Teflon clamp to spout mount bracket - SET OF FOUR.3mf, Teflon clamp to spout mount bracket v1.STL, Teflon clamp to spout mount bracket v2.3mf, Teflon clamp to spout mount bracket v2.stl]
2026-03-26 Reorganizing spout related stl and emf files
    [ALL THREE Spout to Delivery Frame Mounts (Two Edge, One Center).3mf, Center Spout Mount to Delivery Frame-bearing-mount.STL, Center Spout to Delivery Frame Mount - ALL Components for ONE.3mf, Center Spout to Delivery Frame Mount.STL, EDGE Spout Mount to Delivery Frame-bearing-mount.STL, EDGE Spout to Delivery Frame Mount - ALL Components for ONE.3mf, EDGE Spout to Delivery Frame Mount.STL, Spout 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]
2026-03-28 More organizing and adding updated stls
    [10x100mm Linear Rod Clamp v3.stl, ALL Linear Actuator Components.3mf, ALL THREE Spout to Delivery Frame Mounts (Two Edge, One Center).3mf, All Syringe Holder Components.3mf, All Valve Driver Case Components.3mf, Base Connecting Frame Bar (L).stl, Base Connecting Frame Bar (R).stl, Clamp to Base Bracket v3.stl]
2026-03-28 Similar reorganizing for step files
    [100 mm rod.SLDPRT, 100 mm rod.STEP, 10x100mm Linear Rod Clamp v3 - TVD edit.step, Clamp to Base Bracket v3 - TVD edit1.step, Leg Mounting Plate.SLDPRT, Leg Mounting Plate.STEP, Mount Bottom Mirror.SLDPRT, Mount Bottom Mirror.STEP]
2026-04-06 Updating syringe holder top and spout clamp and bracket files
    [Print Teflon Tube Spout Clamp v2.1.3mf, Print Teflon Tube Spout Clamp v2.3mf, Print spout clamp to mount bracket v2.3.3mf, Spout clamp to mount bracket v1.STL, Spout clamp to mount bracket v2.2.stl, Spout clamp to mount bracket v2.3.stl, Syringe Holder Top Lock v3.2.3mf, Syringe Holder Top Lock v3.2.stl]
2026-04-15 Valves can't repeat (doesn't affect side trial order)
    Only applies when there are more than 1 valve per side.
2026-05-26 Revert "Valves can't repeat (doesn't affect side trial order)"
    This reverts commit d0c6b502fe54d0badd8db7792d43a4c47857dda8.
2026-05-26 Full random trial order test protocol
    20 consec trial type limit. 10 consec valve type limit.
2026-05-27 Adding c2d files for faceplates and doors
    It looks like some of these were lost from a previous commit on Blake's version?
    [Top Lock Keepers v2.3.3mf, Valve Frame Front Right Foot.3mf]
2026-05-31 First attempt at test protocol w lick offset events
    Also: minor update to pivot mount design for animal box latches
    [Top Lock Latching Components v2.5.3mf, Top Lock Pivot Mount v2 (prints 4).3mf, Top Lock Pivot Mount v2.stl]
2026-05-31 Small syntax fixes for lick offset events for valve opening
2026-06-03 2nd lick offset test protocol (pulsed stimulus delivery)
    Intended to be used with 10ul per lick for 3 licks during sampling and 4 licks for reward.
2026-06-20 Small adjustments to lickoffset protocols and adding backup calibration files
2026-06-20 Adding some printing files and STLs for current valve/syringe holder, delivery frame, and a few other parts
    [1 to 8 vac splitter.STL, ALL Cage Alignment Components.3mf, Cage Alignment Large.STL, Cage Alignment small.STL, Clamp to Base Bracket v4.3mf, Clamp to Base Bracket v4.stl, FULL Spout Mount v2.3mf, Print spout clamp to mount bracket v2.3.3mf]
2026-06-30 New Calibration Values with Higher Measurements for Preload
2026-07-01 Reorganizing older protocols, update to valve timing function, and a prototype protocol for vac and rinse
2026-07-01 Minor edits for testing v3 with rinse and vac before running with TD10-14 tomorrow.
    Also updating how valve time update function works to maintain compatibility with older protocols.
2026-07-09 Current version of rinse protocol
2026-07-28 Reorganizing printable files and adding some updated delivery frame files
    [1 to 8 vac splitter.SLDPRT, 1 to 8 vac splitter.STEP, 100 mm rod.SLDPRT, 100 mm rod.STEP, 10x100mm Linear Rod Clamp v3 - TVD edit.step, 10x100mm Linear Rod Clamp v3.stl, 10x100mm Linear Rod Clamp.SLDPRT, 10x100mm Linear Rod Clamp.STEP]
2026-08-26 Adding 1st attempt at new rinse protocol with gas clearing (v3.5). Moving old testing protocol w rinse.
    Old v3 was the first attempt of having a shared channel with water rinse (spout connected to a multi-channel manifold). This new protocol is for use with a new manifold with check valves to allow for a gas clearing step (also with new FFKM sealed valves).
2026-08-26 Modified valve timings, added gas and priming delays for testing v3.5. Small edits to AllDoorsDown
2026-08-27 Attempt to combine port classes into a single class
    Other changes: lick onset and offset events labelled separately. Counter and contact triggers use onset, valve opening uses offset. Attempted to improve readability overall with port information names. Removed old variable names based on having 2 center spouts.
2026-08-27 Couple small fixes (variable name updates) for testing v3.5
2026-09-06 Minor reorganizing of some print files
    [ALL Cage Alignment Components.3mf, ALL Frame Z-Posts.3mf, Center Door&Vac Rail Attachment.3mf, Frame Z Post to Breadboard Mount.STL, Front Leg Left v2.1.stl, Front Leg Right v2.1.stl, Print All Cage Legs.3mf, Rear Leg - Left.stl]
2026-09-09 testing_v3 now also saves port properties at the start of the session
    Port events and actions saved (door motors, lick onset/offset, etc...)
2026-09-12 STEP for pee tray alignment
    [pee try alignment parts.STEP]
2026-09-12 Reorganizing some box cad files
    [Cage Top.STEP, Top Handle.STEP, Top Lock Keeper (FR Left).STEP, Top Lock Keeper (FR Right).STEP, Top Lock Latching Components.STEP, Top Lock Pivot Mounts.STEP, pee try alignment parts.STEP]
2026-09-28 New trial order matrix (0.3 alternation tolerance) and updates to alignment and delivery frame print files
    [ALL Cage Alignment Components.3mf, ALL frame tower top brackets.3mf, Print Spout Mount Assembly v2.1.3mf, frame tower top left bracket v2.3mf, frame tower top left bracket v2.stl, frame tower top right bracket v2.3mf, frame tower top right bracket v2.stl]
2026-09-28 testing v3 w driver valve and moving old protocols to appropriate folder
2026-09-30 Draft for v3.6 of testing protocol and new startup file for MATLAB
    Trying to rearrange some protocol format to make it easier to read and edit in the future. Also implementing some smaller changes to protocol (always 3 dry licks in the center, 3 rewarded licks for the lateral, 15s punishment, etc... ).
    Startup file is meant to be saved to the "userpath." Runs when opening MATLAB. Rotates stimulus valve/column assignments each day (using the currentDayConditions function.
2026-10-07 Small fixes: ValveModule name and saving experimentVariables
2026-10-16 New valve stimulus select UI on startup, integration with testing_v3
    Plus removing some old junk from data
2026-10-28 Updated parts for cage alignment, animal box, new hybrid stimulus column holder, vac adaptor
    Hybrid column holder is chromaflex and syringes
2026-10-29 Adding and reorganizing a bunch of rig printed part files (trying to clean up to make current parts easier to find)
